tanai-prathapam/-lab7_445L_personal/Lab07BReport.docx

Name: __Jonathan Simon ; Egan Wang ; Aleena Khatum ; Tanai Prathapam____

EID: __jes7539 ; ew23776 ; aak3265 ; tsp824 _____

Semester: Fall 2026

Course: ECE445L

Deliverable 1: I have pushed my updated Requirements document to GitHub (Yes/No): Yes

Deliverable 2: I have pushed my final KiCad project, schematic, and PCB files to GitHub (Yes/No): Yes

Deliverable 3: I have pushed my final MSPM0_Pins_Assignments.xlsx to GitHub (Yes/No): Yes

Deliverable 4: Photographs of the top and bottom (mirrored) of the PCB showing all components are the correct size and the PCB fits in the box (Figure 7A.2 and Figure 7B.7). n/a

Deliverable 5: I have pushed my low-level header, code, unit test files, and integration test file to GitHub (Yes/No): Yes

Deliverable 6: Include results of integration testing.

E) Analysis and Discussion Questions:

1. List the debugging techniques you used to do integration testing? How intrusive were they?
  a. We tested things individually first because unit testing let us ensure that the fundamental pieces operate as intended. In particular, we built a single LED group and tested that on a breadboard, the keypad was also build and testing on a breadboard, the mister was connected to a single 3v3 line and the microcontroller and interacted with using a GPIO pin, the barcode scanner was tested with the microcontroller directly using two 3v3 lines. The LCDs have been tested in previous labs. We used memory dumps, multimeters for active voltage testing, and message in a bottle testing. The most intrusive form of debugging that we used is print statements. Aside from that, debugging was minimally intrusive.
2. What are one or two high risk aspects of your design, and what mitigation steps have you taken to reduce risks?
  a. A lot of the code was reused from previous labs, so a few risks of combining previous code is overlapping interrupts and CPU utilization.
  b. When designing the PCB, we did so without knowing the actual pitch of the JST connectors. Similarly, for printing the coils, we designed them without knowing the actual measurements of the motor shaft. So, we needed to figure out the measurements using alternate methods. Also, a big part of our design was dependent on the coil printing well and being stiff enough to dispense vending machine items.
3. Explain which team skill (https://users.ece.utexas.edu/~valvano/EE445L/ebook/Chapter3_HumanInterfaces.htm) has been most difficult so far for your group.
  a. I think the team skill that has been most difficult for our group is time management . It is really difficult to coordinate all of our schedules when everyone is so busy and involved in so many different things. The way that we have worked around that is by trying to make it routine to stay in the lab on days that we have checkout.

Lab 7B report ECE445L
