tanai-prathapam/-lab7_445L_personal/RequirementsDocument.docx

## Project Requirements Document:

1) Overview

a) Objectives: Build a miniature carnival-themed vending machine that dispenses candy through keypad selection and combines student ID scanning, LCD displays, lighting, music, mist, and a launcher into an interactive experience.

b) Interactions with Existing Systems: The main controller will interface with the barcode scanner, SD card, LCDs, and peripheral driver circuits. No connection to a campus identification database is planned.

c) Terminology:

- PCB: Printed circuit board connecting the electronic components.
- UI: User interface for displaying instructions and selections.
- Vending coil: Motor-driven spiral that releases a selected product.
- Ejection orifice: Output opening through which candy is launched.

2) Functional Description

a) Functionality: The system will read student ID barcodes and accept product selections through a keypad. One LCD will display SD card content, and the other will display the active UI. The selected vending coil will release candy into the output area. LEDs will illuminate when candy arrives, and the launcher will eject it toward the user. Speakers will play background music, and misters will produce mist around the output opening.

i) Data flow graph:

flowchart TD

A["Keypad selection"] --> C["Controller"]

B["Student ID barcode"] --> C

D["SD card content"] --> C

C --> E["LCD displays"]

C --> F["Motor drivers and vending coils"]

F --> G["Candy in output area"]

G --> H["Arrival indication"]

H --> C

C --> I["Launcher actuation"]

C --> J["LEDs, speakers, and misters"]

The method for detecting candy arrival will be finalized during implementation.

b) Performance: The following are proposed acceptance targets.

Measure | Target | Verification
Keypad response | UI updates within 250 ms | Time input-to-display response
Barcode reading | At least 9 successful reads in 10 attempts | Scan supported student IDs
Dispensing accuracy | Correct product released in at least 9 of 10 trials | Test each product slot
Dispensing time | Candy reaches the output area within 5 seconds of selection | Time repeated trials
Launch consistency | Candy reaches a defined collection zone in at least 9 of 10 trials | Test at a fixed launcher setting
Integrated operation | Complete 10 consecutive cycles without reset or jam | Run the full system

c) Usability: The keypad will provide labeled product choices. The active UI will show instructions, the selected product, and dispensing status. The second LCD will display SD card content. Lighting will identify the output opening, and launching will occur only when the output path is clear.

i) Proposed call graph:

flowchart TD

A["main()"] --> B["initializeSystem()"]

A --> C["processInputs()"]

A --> D["updateDisplays()"]

A --> E["runVendingCycle()"]

C --> F["readKeypad()"]

C --> G["readBarcode()"]

D --> H["readSDContent()"]

E --> I["dispenseProduct()"]

E --> J["controlEffects()"]

E --> K["launchProduct()"]

3) Deliverables

a) Roles and Responsibilities:

Team member | Responsibilities
Egan | PCB schematic and routing
Jonathan | Hardware and software for the barcode scanner, misters, and keypad
Aleena | Hardware and software for LEDs, SD card, motors, solenoid, speakers, and vending coils
Tanai | Enclosure and launching mechanism, including the winch motor

All members will contribute to integration, testing, and documentation. Aleena and Tanai will coordinate the launcher’s electrical and mechanical interfaces.

b) Reports: Reports for Labs 7A, 7B, and 10 will be written and submitted.

c) Outcomes: The primary deliverable is a working miniature carnival-themed vending machine with an assembled PCB, enclosure, firmware, and integrated peripherals. Supporting deliverables include schematics, PCB layout files, source code, and test results. The project is complete when all listed features operate together and meet the agreed acceptance targets.
