tanai-prathapam/-lab7_445L_personal/Lab07AReport.docx

Name: __Jonathan Simon ; Egan Wang ; Aleena Khatum ; Tanai Prathapam____

EID: __jes7539 ; ew23776 ; aak3265 ; tsp824 _____

Semester: Fall 2026

Course: ECE445L

All team members have reviewed and approved team skills contract (https://users.ece.utexas.edu/~valvano/EE445L/ebook/Chapter3_HumanInterfaces.htm) (Yes/No): Yes

https://docs.google.com/document/d/1b0H_l2s_C3Buwb_I0p0ZEJCIzjKjUqObAgL3oR6PWzI/edit?usp=sharing

Deliverable 1: I have pushed my updated Requirements document to GitHub (Yes/No): Yes

Deliverable 2: I have pushed my KiCad preliminary schematic to GitHub (Yes/No): Yes

Deliverable 3: I have pushed my updated MSPM0_Pins_Assignments.xlsx to GitHub (Yes/No): Yes

Deliverable 4: I have pushed my updated BOM to GitHub (Yes/No): Yes

Deliverable 5: List the needed supply voltages and estimated current for each voltage (show how these were determined).

Rail | Subcomponent | Active current (mA) | Idle current (mA) | Design-check current (mA) | Basis or calculation
3.3 V | uC1 | 8.1 | 8.1 | 12 | Active: 1 MCU x 8.1 mA = 8.1 mA, D typical reference. Idle: same RUN-current allowance = 8.1 mA, A; sleep is not established. Design: 1 x 12 mA = 12 mA, A.
3.3 V | uC2 | 8.1 | 8.1 | 12 | Active: 1 MCU x 8.1 mA = 8.1 mA, D typical reference. Idle: same RUN-current allowance = 8.1 mA, A. Design: 1 x 12 mA = 12 mA, A.
3.3 V | UDecoder1 | 0.100 | 0.010 | 1.000 | A allowances: active = 0.100 mA; idle = 0.010 mA; design = 1.000 mA..
3.3 V | RPU1 / CH_PD input leakage | 0.001 | 0.001 | 0.010 | A leakage: active and idle = 1 uA / 1000 = 0.001 mA. Design = 10 uA / 1000 = 0.010 mA. The pull-up does not continuously draw 3.3 V / 10 kOhm when its input is high.
3.3 V | RPU2 | 0.165 | 0 | 0.330 | Low-state current = (3.3 V - 0 V) / 10 kOhm = 0.330 mA. Active: 0.330 mA x 0.50 low-state fraction = 0.165 mA, A duty. Idle: (3.3 V - 3.3 V) / 10 kOhm = 0 mA. Design: 0.330 mA x 1 = 0.330 mA.
3.3 V | ESP8266 module | 80 | 50 | 300 | Active: 1 x 80 mA = 80 mA, C average applied to the module. Idle: 1 x 50 mA = 50 mA, A. Design burst: 1 x 300 mA = 300 mA, A.
3.3 V | TFT1, including backlight | 50 | 50 | 60 | Active: approximately 50 mA with full backlight, D manufacturer reference. Idle: backlight remains on, so 1 x 50 mA = 50 mA, A application. Design: 1 x 60 mA = 60 mA, A.
3.3 V | TFT2, including backlight | 50 | 50 | 80 | A similar-display allowances: active = 1 x 50 mA = 50 mA; idle with backlight on = 50 mA; design = 1 x 80 mA = 80 mA.
3.3 V | One SD card | 10.9 | 1 | 100 | All A. Active average = (0.10 x 100 mA) + (0.90 x 1 mA) = 10.9 mA. Idle = 1 mA. Design access current = 100 mA. Subtract this row if no card is installed.
3.3 V | LS1 through Q16 | 20.625 | 0 | 412.5 | Conditional A model: on-current = (3.3 V - 0 V) / 8 Ohm = 0.4125 A = 412.5 mA. Active average = 412.5 mA x 0.50 tone duty x 0.10 audio occupancy = 20.625 mA. Idle = 0. Design continuous-on case = 412.5 mA.
3.3 V | LS2 through Q17 | 20.625 | 0 | 412.5 | Conditional A model: on-current = (3.3 V - 0 V) / 8 Ohm = 412.5 mA. Active average = 412.5 mA x 0.50 x 0.10 = 20.625 mA. Idle = 0. Design continuous-on case = 412.5 mA.
3.3 V, provisional | Atomizer1 | 150 | 1 | 300 | A module allowances: active = 1 x 150 mA = 150 mA; disabled idle = 1 mA; design = 300 mA.
3.3 V, provisional | Atomizer2 | 150 | 1 | 300 | A module allowances: active = 1 x 150 mA = 150 mA; disabled idle = 1 mA; design = 300 mA.
3.3 V | ID reader | 190 | 20 | 250 | Active allowance = 1 x 190 mA = 190 mA, A proxy based on a representative reader. Idle = 20 mA, A. Design = 250 mA, A. Your exact reader has not been identified.
3.3 V | LED branch 1 | 23.334 | 0 | 30.801 | A: R = 53.57 Ohm from the schematic note; nominal Vf = 2.0 V; Vds = 0.05 V. Active = (3.3 V - 2.0 V - 0.05 V) / 53.57 Ohm = 23.334 mA. Idle = 0. Design with Vf = 1.6 V: (3.3 - 1.6 - 0.05) V / 53.57 Ohm = 30.801 mA.
3.3 V | LED branch 2 | 0 | 0 | 30.801 | A operating state: active and idle = 0 because this LED is off. Design: (3.3 V - 1.6 V - 0.05 V) / 53.57 Ohm = 30.801 mA.
3.3 V | LED branch 3 | 0 | 0 | 30.801 | A operating state: active and idle = 0 because this LED is off. Design: (3.3 V - 1.6 V - 0.05 V) / 53.57 Ohm = 30.801 mA.
3.3 V | Keypad pull currents | 0.0825 | 0 | 1.320 | A equivalent pulls and scan duty. Active = (3.3 V / 10 kOhm) x 0.25 = 0.0825 mA. Idle assumes no conducting pull path = 0. Design = 4 conducting paths x (3.3 V / 10 kOhm) = 1.320 mA.
3.3 V | External MOSFET gate charging | 0.0144 | 0 | 0.048 | Igate = number of switching gates x Qg x frequency. Active = 3 x 2.4 nC x 2 kHz = 14.4 uA = 0.0144 mA. Idle assumes no switching = 0. Design = 4 x 6 nC x 2 kHz = 48 uA = 0.048 mA. D gate-charge references; A frequency, gate count and application to 3.3 V drive.
3.3 V | U1 VREF/control inputs | 0.043 | 0.010 | 0.120 | Active = 10 uA assumed VREF leakage + 33 uA datasheet typical high-input current = 43 uA = 0.043 mA. Idle = 10 uA / 1000 = 0.010 mA, A. Design = 20 uA assumed VREF leakage + 100 uA datasheet maximum high-input current = 0.120 mA.
3.3 V | Other leakage | 0.100 | 0.100 | 1.000 | A aggregate allowance for capacitor, protection and other small leakage: active = 0.100 mA; idle = 0.100 mA; design = 1.000 mA.
5 V | M1–M12, one selected N20 motor | 98 | 0 | 980 | S: 35 mA at 3 V and 56 mA at 6 V, loading unspecified. A interpolation: 35 mA + [(5 V - 3 V) / (6 V - 3 V)] x (56 mA - 35 mA) = 49 mA. Active allowance = 2 x 49 mA = 98 mA. Idle = 0. Design allowance = 20 x 49 mA = 980 mA.
12 V | Mwinch1 | 1000 | 0 | 3000 | A allowances: running = 1 x 1.0 A = 1000 mA; idle = 0; startup/stall design allowance = 1 x 3.0 A = 3000 mA.
12 V | DRV8231A supply overhead | 3 | 0.001 | 4 | D references at VM = 24 V: active typical = 3 mA; sleep maximum = 1 uA / 1000 = 0.001 mA; active maximum = 4 mA. Using these at 12 V is A.
12 V | Mfeeder1 solenoid | 1200 | 0 | 1200 | S energized current: 1.2 A x 1000 = 1200 mA. Equivalent resistance = 12 V / 1.2 A = 10 Ohm. Idle = 0. Design uses the supplied 1200 mA on-current, not a verified maximum.
12 V | Other leakage | 0.100 | 0.100 | 1.000 | A aggregate allowance: active = 0.100 mA; idle = 0.100 mA; design = 1.000 mA.

Deliverable 6: I have pushed my low-level header, code, and unit test files to GitHub (Yes/No): Yes

Deliverable 7: Include results of unit testing.

All unit testing was done within the same project where the main file had different DEBUG_MODEs to select the specific component we want to test. Our unit testing showed a successful toggle of the water atomizer. The motor and barcode reader unit testing is currently in progress. The hardware is in our hands, and we are verifying it is functional first by supplying power.

Deliverable 8 (5pt EC): Show dated proof of TIW Training (due at the time of Lab7A report)

~~Deliverable~~ ~~9~~ ~~(10pt EC):~~ ~~single chip (points given in Lab 10 if the single chip works)~~

Analysis and Discussion Questions:

1. List the debugging techniques you used to do unit testing? How intrusive were they?

We completely isolated the test of each component by assigning different DEBUG_MODES. In each test, only the specific component’s hardware is initialized and then tested by calling its respective functions. To test whether the microcontroller GPIO PA1 pin is properly outputting the correct voltage after every 5 seconds, we used a DVM to measure the output voltage. The mister’s board came with an LED that showed the state it is in and aided in our debugging to understand what the board is attempting to do. The DVM is not intrusive as it is just reading the voltage out of the GPIO pin.

2. What are the differences between unit testing, integration testing, and functional testing?

Unit testing tests the individual modules completely isolated from the other modules. Integration testing puts all the modules together and to validate that they can coordinate their tasks at the appropriate time. Functional testing tests if all their outputs when working together are all valid and expected outputs.

Lab 7A report ECE445L
