tanai-prathapam/-lab7_445L_personal/sw/src/LM4041design.xlsx

Goal: design a shunt reference circuit
Jonathan Valvano, ECE445L
Desired Vz | 1.65 | volts | 1) pick a desired reference voltage Vz (volts)
Vref | 1.233 | volts | LM4041 parameter
R1 | 47 | kohm | 2) choose a standard resistance value (kohm)
best R2 | 15.89537713 | kohm
Pick R2 | 16 | kohm | 3) pick a standard value for R2 close to best R2
Actual Vref | 1.652744681 | volts | Vz=Vref(1+R2/R1)
Vs | 3.3 | volts | V supply
Rin | 10000 | kohm | 4) estimate input impedence on Vz (e.g., to DAC)
Iz | 0.08 | mA | LM4041 parameter
Iref | 0.02623404255 | mA | Vz/(R1+R2), Ohms Law, current through R1,R2
IL | 0.0001652744681 | mA | Vz/Rin, Ohms Law, current through Rin
I total | 0.106399317 | mA | Iz+Iref+IL
max Rs | 15.4818223 | kohm | (Vs-Vz)/Itotal
 |  |  | 5) choose Rs less than max Rs
