tanai-prathapam/-lab7_445L_personal/hw/ECE445L_Lab7/Water Atomizer Reverse Engineering.pptx

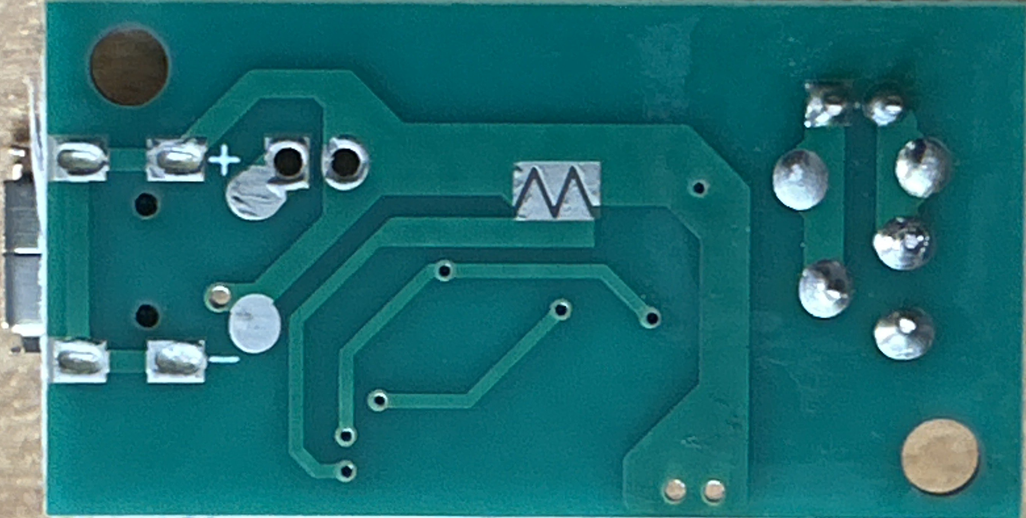
[picture p1: figure]
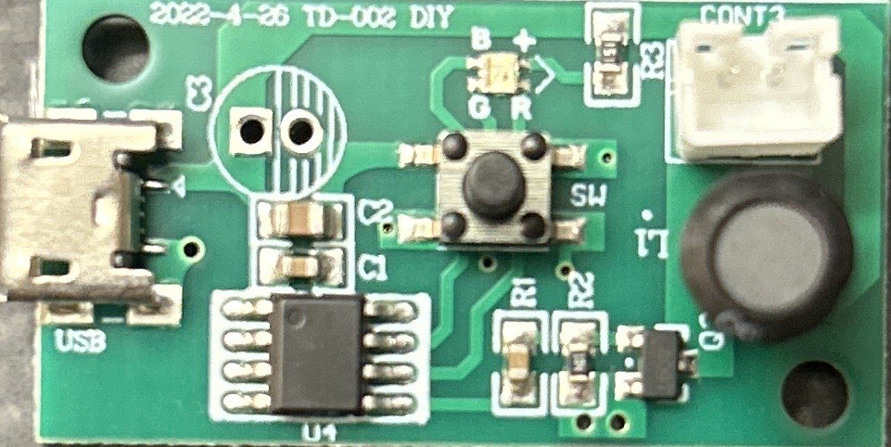
[picture p2: figure]
