tanai-prathapam/-lab7_445L_personal/Lab7BOM_orders.xlsx

Bill of Materials |  |  | 2026-10-30 | "not free" means you have to buy it |  | "free sample" means you have to order it
ECE445L Fall 2026 |  |  | EE445L pays for the PCB | "Cabinet means in one of the six black cabinets in professsor's office (bring a print out of your SCH")
 |  |  |  | "Professor" means ask your professor quantity and style will vary (bring a print out of your SCH circuit)
Qty Note | REF DES Note (http://projects.ece.utexas.edu/valvano/wiki/doku.php?id=pcbartist:schematics) |  |  | "Box means in box in your professor's office (bring a print out of your SCH circuit)
Quantity | REF DES | Type | Description | Manufacturer | Mfg. P/N | Distributor | P/N | Unit cost | Cost | Where to get it? | Inventory | Order link
2 | LS1, LS2 | ASM | Speakers |  |  |  |  | $0.00 | $0.00 | Checkout
0 |  | ASM | 9V battery snap, T-type |  |  |  |  | $0.50 | $0.00 | Box
0 |  | ASM | Black case, 7.5" by 4.3" by 2.2" | Hammond | 1591ESBK | Mouser | 546-1591ES-BK | $5.18 | $0.00 | Box | http://www.hammondmfg.com/pdf/1591E.pdf
0 |  | ASM | Electret microphone | Panasonic |  |  |  | $0.50 | $0.00 | Cabinet
0 |  | CAP | Ceramic, X7R, 20%, 1 uF |  |  | Jameco | 81509 | $0.35 | $0.00 | Cabinet
0 |  | CAP | Ceramic, Z5U, -20/+80%, 0.47 uF | Kemet | C320C474M5U5TA | Digikey | 399-4309-ND | $0.40 | $0.00 | Cabinet
0 |  | CAP | Ceramic, Z5U, -20/+80%, 0.1 uF |  |  | Digikey | 399-4151-ND | $0.04 | $0.00 | Cabinet
0 |  | CAP | Ceramic, Z5U, -20/+80%, 0.033 uF |  |  | Digikey | 399-4298-ND | $0.40 | $0.00 | Cabinet
0 |  | CAP | Ceramic, Z5U, -20/+80%, 0.027uF |  |  |  |  | $0.40 | $0.00 | Cabinet
0 |  | CAP | Ceramic, Z5U, -20/+80%, 0.01 uF |  |  | Digikey | 399-4148-ND | $0.40 | $0.00 | Cabinet
0 |  | CAP | Ceramic, Z5U, -20/+80%, 4.7 nF |  |  | Digikey | 399-4188-ND | $0.40 | $0.00 | Cabinet
0 |  | CAP | Ceramic, Z5U, -20/+80%, 2.2 nF |  |  |  |  | $0.40 | $0.00 | Cabinet
0 |  | CAP | Ceramic, Z5U, -20/+80%, 1 nF |  |  |  |  | $0.40 | $0.00 | Cabinet
0 |  | CAP | Ceramic Z5U, -20/+80%, 470 pF |  |  |  |  | $0.03 | $0.00 | Cabinet
0 |  | CAP | Ceramic Z5U, -20/+80%, 330 pF |  |  |  |  | $0.03 | $0.00 | Cabinet
0 |  | CAP | Ceramic Z5U, -20/+80%, 220 pF |  |  |  |  | $0.03 | $0.00 | Cabinet
0 |  | CAP | Ceramic Z5U, -20/+80%, 100 pF |  |  |  |  | $0.03 | $0.00 | Cabinet
0 |  | CAP | Ceramic Z5U, -20/+80%, 22 pF |  |  | Jameco | 15405 | $0.03 | $0.00 | Cabinet
0 |  | CAP | Ceramic C0G, 10%, 10 pF | Murata 50V 5% | RDE5C1H100J0P1H03B | Digikey | 490-8629-ND | $0.31 | $0.00 | Cabinet
0 |  | CAP-Tant | Tantalum, 16V, 20% 2.2 uF | AVX Corporation | TAP225M016CCS | Digikey | 478-8819-ND | $0.29 | $0.00 | Cabinet
0 |  | CAP-Tant | Tantalum, 16V, 10% 4.7 uF |  |  | Digikey | 478-1904-ND | $0.22 | $0.00 | Cabinet
0 |  | CAP-Tant | Tantalum, 20V, 10%, 1 uF |  |  | Digikey | 478-1833-ND | $0.32 | $0.00 | Cabinet
0 |  | CAP-Tant | Tantalum, 10UF 20V 10% |  |  | Digikey | 478-1840-ND | $0.56 | $0.00 | Cabinet
0 |  | CAP-Tant | Tantalum, 35V, 10%, 0.47 uF |  |  | Jameco | 33531 | $0.19 | $0.00 | Cabinet
0 |  | CAP-Elec | Electrolytic, 16V, 100 uF, cap 20%, ESR=20mV |  |  | Mouser | 661-APSF160E101MF05S | $0.38 | $0.00 | Cabinet
0 |  | CON | 2 to 40 pin 0.1 in header (price per pin) |  |  | AllElectronics | SHS-40 | $0.02 | $0.00 | Cabinet
0 |  | CON | 2-pin header |  |  | AllElectronics | SBH-2 | $0.10 | $0.00 | Cabinet
0 |  | CON | 2-pin jumper |  |  | AllElectronics | SBC-2 | $0.27 | $0.00 | Cabinet
0 |  | CON | 2-pin jumper |  |  | AllElectronics | SJ-1 | $0.10 | $0.00 | Cabinet
0 |  | CON | Test point, black | Keystone Electronics | 5001 | Digikey | 36-5001K-ND | $0.23 | $0.00 | Cabinet
0 |  | CON | Test point, orange | Keystone Electronics | 5003 | Digikey | 36-5003K-ND | $0.23 | $0.00 | Cabinet
0 |  | CON | Test point, yellow | Keystone Electronics | 5004 | Digikey | 36-5004K-ND | $0.23 | $0.00 | Cabinet
0 |  | CON | Test point, white | Keystone Electronics | 5002 | Digikey | 36-5002K-ND | $0.23 | $0.00 | Cabinet
0 |  | CON | Test point, blue | Keystone Electronics | 5117 | Digikey | 36-5117-ND | $0.23 | $0.00 | Cabinet
0 |  | CON | Test point, green | Keystone Electronics | 5116 | Digikey | 36-5116-ND | $0.23 | $0.00 | Cabinet
0 |  | CON | Test point, red | Keystone Electronics | 5000 | Digikey | 36-5000K-ND | $0.23 | $0.00 | Cabinet
0 |  | CON | 10-pin LCD connector | SamTec | BCS-110-L-S-TE | SamTec |  |  | $0.00 | Cabinet
0 |  | CON | 14-pin LCD connector | SamTec | BCS-114-L-S-TE | SamTec |  |  | $0.00 | Cabinet
0 |  | CON | 16-pin LCD connector | SamTec | BCS-116-L-S-TE | SamTec |  |  | $0.00 | Cabinet
0 |  | CON | 20-pin LCD connector | SamTec | BCS-120-L-S-TE | SamTec |  |  | $0.00 | Cabinet
0 |  | CON | Socket for micro SD card | Molex | 473340001 | Digikey | WM3288CT-ND | $4.02 | $0.00 | professor | do not use, rather included on ST7735
0 |  | CON | USB Mini-B socket, board mount, surface mount | Molex | 56579-0576 | Mouser | 538-56579-0576 | $2.46 | $0.00 | Cabinet
 |  | CON | Micro USB Type B, surface mount | Hirose Connector | ZX62D-B-5PA8(30) | Mouser | 798-ZX62D-B-5PA830 | $0.47 | $0.00 | Cabinet
0 |  | CON | USB Mini-B socket, board mount, through hole | Molex | 54819-0519 | Digikey | WM17115-ND | $0.65 | $0.00 | Cabinet
0 |  | CON | BoosterPack connector | FCI | 68021-208HLF | Digikey | 609-3243-ND | $0.26 | $0.00 | Cabinet
0 |  | CON | Logic Analyzer connector | FCI | 68021-208HLF | Digikey | 609-3344-ND | $0.27 | $0.00 | Cabinet
0 |  | CON | JTAG 1 by 5 male header |  |  |  |  | $0.29 | $0.00 | Cabinet
0 |  | CON | 10 pin 2mm socket for Xbee (need two) | SamTec | SQT-110-01-F-S | SamTec |  | $1.00 | $0.00 | Cabinet
0 |  | CON | DB9 serial connector, female, board mount |  |  | Jameco | 15771 | $0.65 | $0.00 | Cabinet
0 |  | CPU | TM4C123GH6PM 64-pin LQFP | TI | TM4C123GH6PMI | Mouser | 595-TM4C123GH6PMI | $11.55 | $0.00 | not required, we expect most students will create a system with the LaunchPad
0 |  | CRYS | NX5032GA-16.000000 | NDK | NX5032GA-16.000000 | Digikey | 644-1037-1-ND | $0.51 | $0.00 | Cabinet | not required, we expect most students will create a system with the LaunchPad
0 |  | DIODE | 1N914 diode | Fairchild | 1N914 | Digikey | 1N914B-ND | $0.05 | $0.00 | Cabinet
0 |  | IC | ACCELER DUAL-AX 2.0G 8PLCC | Analog Devices | ADXL202JQC | Quest Components | ADXL202JQC | $7.50 | $0.00 | professor
0 |  | IC | LM2937 3.3 V regulator TO220, 500mA | TI | LM2937ET-3.3/NOPB | Digikey | LM2937ET-3.3-ND | $1.17 | $0.00 | Cabinet
0 |  | IC | LP2950 3.3V regulator, 100 mA TO-92 | TI | LP2950-33LPRE3 | Digikey | 296-31455-1-ND | $0.19 | $0.00 | Cabinet
0 |  | IC | 78M05 500mA 5V TO-220 regulator | National | LM78M05 | Jameco | 192233 | $0.19 | $0.00 | Cabinet
0 |  | IC | OPA4350 quad op amp | TI | OPA4350 | TI |  |  | $0.00 | free sample
0 |  | IC | TLV5616 12-bit DAC | TI | TLV5616 | TI | TLV5616CP |  | $0.00 | Cabinet or free sample
0 |  | IC | TLV5618 dual 12-bit DAC | TI | TLV5618 | TI | TLV5618ACP |  | $0.00 | free sample
0 |  | IC | MAX539 12-bit DAC | Maxim-IC | MAX539 | Maxim | MAX539ACPA |  | $0.00 | free sample
0 |  | IC | MAX1247 12-bit ADC | Maxim-IC | MAX1247 | Maxim | MAX1247ACPE+ |  | $0.00 | free sample
0 |  | IC | INA122P instrumentation amp | TI | INA122P | TI | INA122P |  | $0.00 | Cabinet or free sample
0 |  | IC | OPA2350 dual op amp | TI | OPA2350PA | TI | OPA2350PA |  | $0.00 | Cabinet or free sample |  |  |  | 1 KD
0 |  | IC | TLC2274 quad op amp | TI | TLC2274ACN | TI | TLC2274ACN | $1.17 | $0.00 | free sample |  |  |  | 2 HD
0 |  | IC | TPA731 audio amp (pin 1 low) 700mW | TI | TPA731D | TI | TPA731D | $1.84 | $0.00 | Cabinet or free sample |  |  |  | 3 AD
0 |  | IC | TPA751 audio amp (pin 1 high) 700mW | TI | TPA751D | TI | TPA751D | $1.84 | $0.00 | free sample |  |  |  | 4 JD
0 |  | IC | LM4041CILPR shunt diode reference | TI | LM4041CILPR | TI | LM4041CILPR | $0.90 | $0.00 | Cabinet or free sample |  |  |  | 5 CD
0 |  | IC | AD8032 dual op amp | Analog Devices | AD8032ANZ | Analog Devices | AD8032ANZ | $4.47 | $0.00 | free sample |  |  |  | 6 BD
0 |  | IC | L293 Motor H bridge | TI | L293NE | Digikey | 296-9519-5-ND | $3.50 | $0.00 | not free |  |  |  | 7 MD
0 |  | IC | DRV8848 | TI | DRV8848PWP | TI
0 |  | IC | 74HC595 |  |  | Jameco | 46105 | $0.40 | $0.00 | Cabinet |  |  |  | 8 ED
0 |  | IC | 74HC165 |  |  | Jameco | 45495 | $0.30 | $0.00 | Cabinet |  |  |  | 9 FD
0 |  | IC | 74HCT125N | TI | SN74HCT125N | Mouser | 595-SN74HCT125N | $0.53 | $0.00 | Cabinet |  |  |  | 9 FD
0 |  | IC | RS232 driver | STMicroelectronics | ST232CN | Jameco | 2001171 | $0.58 | $0.00 | not free |  |  |  | 0 ND
0 |  | JACK | DC Power MALE 2.1mm |  |  | Jameco | 101179 | $0.55 | $0.00 | Cabinet |  |  |  | * LD
0 |  | JACK | Stereo Jack, or audio jack |  |  | AllElectronics | MJW-12 | $0.09 | $0.00 | Cabinet |  |  | 87YY3212A
0 |  | KEY | 3 by 4 common bus (D), keypad | Grayhill | 87YY3212A-506 | BGMicro | SWT1109 | $2.99 | $0.00 | Box | http://docs.bgmicro.com/pdf/swt1109.pdf
 |  | LCD | 84 by 48 LCD | Nokia | 5110 | Sparkfun | 10168 | $9.95 | $0.00 | not free
1 | TFT1 | LCD | 18-bit color 128*160 1.8" TFT LCD display | Adafruit | 358 | Mouser |  | $19.95 | $0.00 | Cabinet | Schematic TFT1; cost from schematic, not a current quote
0 |  | LED | Green 2mA 5mm diffused | Avago Technologies | HLMP-4740 | Digikey | 516-1327-ND | $0.29 | $0.00 | Cabinet
0 |  | LED | Red 1.6V 1mA 5mm diffused | Avago Technologies | HLMP-D150 | Digikey | 516-1323-ND | $0.29 | $0.00 | Cabinet
0 |  | LED | Yellow 2mA 5mm diffused | Avago Technologies | HLMP-4719 | Digikey | 516-1326-ND | $0.29 | $0.00 | Cabinet
0 |  | LED | Orange 10mA 5mm diffused | Avago Technologies | HLMP-D401 | Digikey | 516-1330-ND | $0.29 | $0.00 | Cabinet
0 |  | LED | Blue 10mA 5mm diffused |  |  |  |  | $0.99 | $0.00 | Cabinet | warning, the blue LEDs are very bright
0 |  | PCB | PCB plus shipping | JLCPCB |  | JLCPCB |  | $20.00 | $0.00 | http://www.4pcb.com/
0 |  | POT | 20K LINEAR SLIDE POT |  |  |  |  | $0.33 | $0.00 | professor
0 |  | POT | 10 K one-turn potentiometer |  |  |  |  | $0.15 | $0.00 | Cabinet
0 |  | POT | 20 K one-turn potentiometer |  |  |  |  | $0.15 | $0.00 | Cabinet
0 |  | RES | Carbon 1/6W, 5%, 100 | Yageo | CFR-12JB-100R | Digikey | 100EBK-ND | $0.02 | $0.00 | Cabinet
0 |  | RES | Carbon 1/6W, 5%, 220 | Yageo | CFR-12JB-220R | Digikey | 220EBK-ND | $0.02 | $0.00 | Cabinet
0 |  | RES | Carbon 1/6W, 5%, 270 | Yageo | CFR-12JB-270R | Digikey | 270EBK-ND | $0.02 | $0.00 | Cabinet
0 |  | RES | Carbon 1/6W, 5%, 330 | Yageo | CFR-12JB-330R | Digikey | 330EBK-ND | $0.02 | $0.00 | Cabinet
0 |  | RES | Carbon 1/6W, 5%, 470 | Yageo | CFR-12JB-470R | Digikey | 470EBK-ND | $0.02 | $0.00 | Cabinet
0 |  | RES | Carbon 1/6W, 5%, 510 | Yageo | CFR-12JB-510R | Digikey | 510EBK-ND | $0.02 | $0.00 | Cabinet
0 |  | RES | Carbon 1/6W, 5%, 680 | Yageo | CFR-12JB-680R | Digikey | 680EBK-ND | $0.02 | $0.00 | Cabinet
0 |  | RES | Carbon 1/6W, 5%, 820 | Yageo | CFR-12JB-820R | Digikey | 820EBK-ND | $0.02 | $0.00 | Cabinet
0 |  | RES | Carbon 1/6W, 5%, 1K | Yageo | CFR-12JB-1K0 | Digikey | 1.0KEBK-ND | $0.02 | $0.00 | Cabinet
0 |  | RES | Carbon 1/6W, 5%, 1.2K | Yageo | CFR-12JB-1K2 | Digikey | 1.2KEBK-ND | $0.02 | $0.00 | Cabinet
0 |  | RES | Carbon 1/6W, 5%, 1.5K | Yageo | CFR-12JB-1K5 | Digikey | 1.5KEBK-ND | $0.02 | $0.00 | Cabinet
0 |  | RES | Carbon 1/6W, 5%, 1.8K | Yageo | CFR-12JB-1K8 | Digikey | 1.8KEBK-ND | $0.02 | $0.00 | Cabinet
0 |  | RES | Carbon 1/6W, 5%, 2.0K | Yageo | CFR-12JB-2K0 | Digikey | 2.0KEBK-ND | $0.02 | $0.00 | Cabinet
0 |  | RES | Carbon 1/6W, 5%, 2.2K | Yageo | CFR-12JB-2K2 | Digikey | 2.2KEBK-ND | $0.02 | $0.00 | Cabinet
0 |  | RES | Carbon 1/6W, 5%, 2.7K | Yageo | CFR-12JB-2K7 | Digikey | 2.7KEBK-ND | $0.02 | $0.00 | Cabinet
0 |  | RES | Carbon 1/6W, 5%, 3.3K | Yageo | CFR-12JB-3K3 | Digikey | 3.3KEBK-ND | $0.02 | $0.00 | Cabinet
0 |  | RES | Carbon 1/6W, 5%, 3.9K | Yageo | CFR-12JB-3K9 | Digikey | 3.9KEBK-ND | $0.02 | $0.00 | Cabinet
0 |  | RES | Carbon 1/6W, 5%, 4.7K | Yageo | CFR-12JB-4K7 | Digikey | 4.7KEBK-ND | $0.02 | $0.00 | Cabinet
0 |  | RES | Carbon 1/6W, 5%, 5.1K | Yageo | CFR-12JB-5K1 | Digikey | 5.1KEBK-ND | $0.02 | $0.00 | Cabinet
0 |  | RES | Carbon 1/6W, 5%, 5.6K | Yageo | CFR-12JB-5K6 | Digikey | 5.6KEBK-ND | $0.02 | $0.00 | Cabinet
0 |  | RES | Carbon 1/6W, 5%, 6.8K | Yageo | CFR-12JB-6K8 | Digikey | 6.8KEBK-ND | $0.02 | $0.00 | Cabinet
0 |  | RES | Carbon 1/6W, 5%, 8.2K | Yageo | CFR-12JB-8K2 | Digikey | 8.2KEBK-ND | $0.02 | $0.00 | Cabinet
0 |  | RES | Carbon 1/6W, 5%, 10K | Yageo | CFR-12JB-10K | Digikey | 10KEBK-ND | $0.02 | $0.00 | Cabinet
0 |  | RES | Carbon 1/6W, 5%, 12K | Yageo | CFR-12JB-12K | Digikey | 12KEBK-ND | $0.02 | $0.00 | Cabinet
0 |  | RES | Carbon 1/6W, 5%, 15K | Yageo | CFR-12JB-15K | Digikey | 15KEBK-ND | $0.02 | $0.00 | Cabinet | http://www.kemet.com/kemet/web/homepage/kechome.nsf/vapubfiles/F3101_GoldMax.pdf/$file/F3101_GoldMax.pdf
0 |  | RES | Carbon 1/6W, 5%, 18K | Yageo | CFR-12JB-18K | Digikey | 18KEBK-ND | $0.02 | $0.00 | Cabinet
0 |  | RES | Carbon 1/6W, 5%, 20K | Yageo | CFR-12JB-20K | Digikey | 20KEBK-ND | $0.02 | $0.00 | Cabinet
0 |  | RES | Carbon 1/6W, 5%, 22K | Yageo | CFR-12JB-22K | Digikey | 22KEBK-ND | $0.02 | $0.00 | Cabinet
0 |  | RES | Carbon 1/6W, 5%, 27K | Yageo | CFR-12JB-27K | Digikey | 27KEBK-ND | $0.02 | $0.00 | Cabinet
0 |  | RES | Carbon 1/6W, 5%, 36K | Yageo | CFR-12JB-36K | Digikey | 36KEBK-ND | $0.02 | $0.00 | Cabinet
0 |  | RES | Carbon 1/6W, 5%, 33K | Yageo | CFR-12JB-33K | Digikey | 33KEBK-ND | $0.02 | $0.00 | Cabinet
0 |  | RES | Carbon 1/6W, 5%, 39K | Yageo | CFR-12JB-39K | Digikey | 39KEBK-ND | $0.02 | $0.00 | Cabinet
0 |  | RES | Carbon 1/6W, 5%, 47K | Yageo | CFR-12JB-47K | Digikey | 47KEBK-ND | $0.02 | $0.00 | Cabinet
0 |  | RES | Carbon 1/6W, 5%, 51K | Yageo | CFR-12JB-51K | Digikey | 51KEBK-ND | $0.02 | $0.00 | Cabinet
0 |  | RES | Carbon 1/6W, 5%, 56K | Yageo | CFR-12JB-56K | Digikey | 56KEBK-ND | $0.02 | $0.00 | Cabinet
0 |  | RES | Carbon 1/6W, 5%, 68K | Yageo | CFR-12JB-68K | Digikey | 68KEBK-ND | $0.02 | $0.00 | Cabinet
0 |  | RES | Carbon 1/6W, 5%, 82K | Yageo | CFR-12JB-82K | Digikey | 82KEBK-ND | $0.02 | $0.00 | Cabinet
0 |  | RES | Carbon 1/6W, 5%, 100K | Yageo | CFR-12JB-100K | Digikey | 100KEBK-ND | $0.02 | $0.00 | Cabinet
0 |  | RES | Carbon 1/6W, 5%, 120K | Yageo | CFR-12JB-120K | Digikey | 120KEBK-ND | $0.02 | $0.00 | Cabinet
0 |  | RES | Carbon 1/6W, 5%, 150K | Yageo | CFR-12JB-150K | Digikey | 150KEBK-ND | $0.02 | $0.00 | Cabinet
0 |  | RES | Carbon 1/6W, 5%, 180K | Yageo | CFR-12JB-180K | Digikey | 180KEBK-ND | $0.02 | $0.00 | Cabinet
0 |  | RES | Carbon 1/6W, 5%, 200K | Yageo | CFR-12JB-200K | Digikey | 200KEBK-ND | $0.02 | $0.00 | Cabinet
0 |  | RES | Carbon 1/6W, 5%, 220K | Yageo | CFR-12JB-220K | Digikey | 220KEBK-ND | $0.02 | $0.00 | Cabinet
0 |  | RES | Carbon 1/6W, 5%, 240K | Yageo | CFR-12JB-240K | Digikey | 240KEBK-ND | $0.02 | $0.00 | Cabinet
0 |  | RES | Carbon 1/6W, 5%, 270K | Yageo | CFR-12JB-270K | Digikey | 270KEBK-ND | $0.02 | $0.00 | Cabinet
0 |  | RES | Carbon 1/6W, 5%, 330K | Yageo | CFR-12JB-330K | Digikey | 330KEBK-ND | $0.02 | $0.00 | Cabinet
0 |  | RES | Carbon 1/6W, 5%, 390K | Yageo | CFR-12JB-390K | Digikey | 390KEBK-ND | $0.02 | $0.00 | Cabinet
0 |  | RES | Carbon 1/6W, 5%, 470K | Yageo | CFR-12JB-470K | Digikey | 470KEBK-ND | $0.02 | $0.00 | Cabinet
0 |  | RES | Carbon 1/6W, 5%, 510K | Yageo | CFR-12JB-510K | Digikey | 510KEBK-ND | $0.02 | $0.00 | Cabinet
0 |  | RES | Carbon 1/6W, 5%, 560K | Yageo | CFR-12JB-560K | Digikey | 560KEBK-ND | $0.02 | $0.00 | Cabinet
0 |  | RES | Carbon 1/6W, 5%, 680K | Yageo | CFR-12JB-680K | Digikey | 680KEBK-ND | $0.02 | $0.00 | Cabinet
0 |  | RES | Carbon 1/6W, 5%, 820K | Yageo | CFR-12JB-820K | Digikey | 820KEBK-ND | $0.02 | $0.00 | Cabinet
0 |  | RES | Carbon 1/6W, 5%, 1M | Yageo | CFR-12JB-1M0 | Digikey | 1.0MEBK-ND | $0.02 | $0.00 | Cabinet
0 |  | RES | Carbon 1/6W, 5%, 10M | Yageo | CFR-12JB-10M | Digikey | 10MEBK-ND | $0.02 | $0.00 | Cabinet
 |  | SW | Tactile Switch, surface mount | C&K Components | KSC353JLFG | Mouser | 611-KSC353JLFG | $0.86 | $0.00 | Cabinet
0 |  | SW | B3F tactile push button switch | Omron Electronics | B3F-1052 | Digikey | SW405-ND | $0.17 | $0.00 | Cabinet
0 |  | SW | Black Off board momentary push buttom |  |  |  |  | $0.35 | $0.00 | Cabinet
0 |  | SW | Red Off board momentary push buttom |  |  |  |  | $0.35 | $0.00 | Cabinet
0 |  | SW | On/off power switch |  |  | BGMicro | SWT1010 | $0.85 | $0.00 | Cabinet
0 |  | TRAN | PN2222 NPN transistor | Fairchild Semiconductor | PN2222 | Digikey | PN2222BU-ND | $0.13 | $0.00 | Cabinet | be careful to get pins 1 and 3 correct, there are two versions of the chip: 2N2222 and PN2222
0 |  | TRAN | TIP120 Darlington NPN, TO220 | Fairchild | TIP120 | Digikey | TIP120-ND | $0.68 | $0.00 | Cabinet
0 |  | TRAN | TIP125 Darlington PNP, TO220 | Fairchild | TIP125 | Digikey | TIP125TU-ND | $0.67 | $0.00 | Cabinet
0 |  | TRAN | IRF540 MOSFET N-channel, TO220 |  | IRF540 | Digikey | IRF540NPBF-ND | $1.95 | $0.00 | professor
0 |  | TRAN | IRLD120PBF | N-MOSFET | DIP-4 | Mouser | 844-IRLD120PBF | $1.58 | $0.00
1 | U_{Decoder}1 | IC | 4 to 16 Positive Logic Decoder | onsemi | MC14514BDWR2G | Digikey | MC14514BDWR2GOSCT-ND | $1.09 | $1.09 | DigiKey | https://www.digikey.com/en/products/detail/onsemi/MC14514BDWR2G/1478882
18 | Q1, Q10, Q11, Q12, Q15, Q16, Q17, Q18, Q19, Q2, Q20, Q3, Q4, Q5, Q6, Q7, Q8, Q9 | TRAN | N-channel MOSFET, SOT-23 | onsemi | NTR4501NT1G | Valvano | 863-NTR4501NT1G |  | $0.00 |  | https://www.onsemi.com/pub/Collateral/NTR4501N-D.PDF
2 | R_{PU}1, R_{PU}2 | RES | 10 kohm resistor, 0805 | Bourns | CRM0805-FX-1002ELF | Valvano | 652-CRM0805FX1002ELF |  | $0.00 |  | https://www.mouser.com/datasheet/3/40/1/CRM0805_1206_2010.pdf
14 | R_{filter}1, R_{gate}1, R_{gate}10, R_{gate}11, R_{gate}12, R_{gate}15, R_{gate}2, R_{gate}3, R_{gate}4, R_{gate}5, R_{gate}6, R_{gate}7, R_{gate}8, R_{gate}9 | RES | 0.25 ohm resistor, 0603 | YAGEO | RL0603JR-070R25L | Mouser | 603-RL0603JR-070R25L | $0.07 | $1.01 |  | https://www.mouser.com/datasheet/3/508/1/PYU_RL_GROUP_521_ROHS_L.pdf
3 | C_{b,uC}1, C_{b,uC}3, C_{b}16 | CAP | 100 nF capacitor, 0603 | Walsin | 0603B104J160CT | Mouser | 791-0603B104J160CT | $0.10 | $0.30 |  | https://www.mouser.com/datasheet/3/317/1/WTC_MLCC_General_Purpose.pdf
2 | C_{b,uC}2, C_{b,uC}4 | CAP | 10 uF capacitor, 0603 | TDK | C1608X7T1A106M080AC | Mouser | 810-C1608X7T1A106M08 | $0.24 | $0.48 |  | https://product.tdk.com/system/files/dam/doc/product/capacitor/ceramic/mlcc/catalog/mlcc_commercial_general_en.pdf
4 | C_{y}1, C_{y}2, C_{y}3, C_{y}4 | CAP | 10 pF capacitor, 0603 | Walsin | 0603N100F101CT | Mouser | 791-0603N100F101CT | $0.12 | $0.48 |  | https://www.mouser.com/datasheet/3/317/1/WTC_MLCC_General_Purpose.pdf
2 | C_{core}1, C_{core}2 | CAP | 0.47 uF capacitor, 0603 | Walsin | 0603B474K6R3CT | Valvano | 791-0603B474K6R3CT | $0.10 | $0.00 |  | https://www.mouser.com/datasheet/2/210/WTC_MLCC_General_Purpose-1534899.pdf
2 | Y1, Y2 | CRYS | 16 MHz crystal, ABM3 | ABRACON | ABM3-16.000MHZ-B2-T | Valvano | 815-ABM3-16-B2-T | $1.10 | $0.00 |  | https://abracon.com/Resonators/abm3.pdf
2 | uC1, uC2 | CPU | MSPM0G3507-Q1, 32-pin VSSOP | Texas Instruments | M0G3507QDGS32RQ1 | Valvano |  |  | $0.00 |  | https://www.ti.com/lit/ds/symlink/mspm0g3507-q1.pdf?ts=1726224116300
13 | D_{flyback}1, D_{flyback}10, D_{flyback}11, D_{flyback}12, D_{flyback}15, D_{flyback}2, D_{flyback}3, D_{flyback}4, D_{flyback}5, D_{flyback}6, D_{flyback}7, D_{flyback}8, D_{flyback}9 | DIODE | ESD5Z12 diode, SOD-523 | Diotec Semiconductor | ESD5Z12 | Mouser | 637-ESD5Z12 | $0.22 | $2.86 |  | https://diotec.com/request/datasheet/esd5z2v5.pdf
2 | D_{flyback}16, D_{flyback}17 | DIODE | Diode, SOD-882D | Panjit | 241-PE1403M1QR100501 | Mouser | PE1403M1Q_R1_00501 | $0.23 | $0.46 |  | https://www.mouser.com/datasheet/3/3736/1/70DF2AA330BF2D29377481CD66AEFD4146E20D02EF29A331550E35DCFDBB0BAF.pdf
17 | C_{b}1, C_{b}10, C_{b}11, C_{b}12, C_{b}14, C_{b}15, C_{b}17, C_{b}2, C_{b}3, C_{b}4, C_{b}5, C_{b}6, C_{b}7, C_{b}8, C_{b}9, C_{pi}1, C_{pi}2 | CAP | 4.7 uF; 0805 | Walsin | 791-0805X475M250CT | Mouser | 0805X475M250CT | $0.08 | $1.29 |  | https://www.mouser.com/datasheet/2/210/WTC_MLCC_General_Purpose-1534899.pdf
13 | R_{choke}1, R_{choke}10, R_{choke}11, R_{choke}12, R_{choke}15, R_{choke}2, R_{choke}3, R_{choke}4, R_{choke}5, R_{choke}6, R_{choke}7, R_{choke}8, R_{choke}9 | RES | 680 ohm value | Panasonic |  | Valvano |  |  | $0.00 |  | https://industrial.panasonic.com/cdbs/www-data/pdf/RDN0000/AOA0000C313.pdf
4 | R_{vref}1, R_{vref}2, R_{vref}3, R_{vref}4 | RES | 0.5 ohm resistor, 0805 | Vishay/Dale | RCWE0805R500FKEA | Mouser | 71-RCWE0805R500FKEA | $0.33 | $1.32 |  | 20019RCWE.fm (https://www.vishay.com/docs/20019/rcwe.pdf)
3 | R_{I_lim}1, R_{I_lim}2, R_{I_lim}3 | RES | Current-limit resistor, 0603; value blank |  |  | Valvano |  |  | $0.00
1 | C_{filter}1 | CAP-Elec | 1200 uF polarized capacitor | KEMET | A7D0MW128M1EAAS011 | Mouser | 80-A7D0MW128M1EAAS11 | $1.34 | $1.34 |  | https://www.mouser.com/datasheet/3/72/1/KEM_A4148_A7D0.pdf
1 | L_{filter}1 | IND | 10 uH inductor; footprint unverified | Pulse Electronics | AMRM00101040100MA1 | Mouser | 673-AMRM101040100MA1 | $0.43 | $0.43 |  | https://www.mouser.com/datasheet/3/508/1/DATASHEET_AMRM00101040_SERIES.pdf
1 | U_{3V3DC}1 | IC | DC/DC converter; 12 V / 3.3 V conflict | XP Power | RBT05W24S3V3 | DigiKey | 1470-RBT05W24S3V3-ND | $2.39 | $2.39 |  | Price for schematic MPN; voltage conflict unresolved. USD, qty 1, excludes shipping/tax. https://www.digikey.com/en/products/detail/xp-power/RBT05W24S3V3/26667101 (https://www.mouser.com/catalog/specsheets/XPPOWER_05_13_2025_RBT05%20Series.pdf)
1 | U1 | IC | H-bridge driver; variant/package conflict | Texas Instruments | DRV8231DDAR | Spirit Electronics | DRV8231DDAR | $1.44 | $1.44 |  | Price for schematic MPN; variant/package conflict unresolved. USD, qty 1, excludes shipping/tax. https://spiritelectronics.com/shop/motor-drivers/drv8231ddar/ (https://www.ti.com/lit/ds/symlink/drv8231a.pdf)
13 | SW_{bypass}1, SW_{bypass}10, SW_{bypass}11, SW_{bypass}12, SW_{bypass}15, SW_{bypass}2, SW_{bypass}3, SW_{bypass}4, SW_{bypass}5, SW_{bypass}6, SW_{bypass}7, SW_{bypass}8, SW_{bypass}9 | SW | Normally-open push switch, 6 mm |  |  | Checkout |  | $0.00 | $0.00
1 | TFT2 | LCD | ST7735R TFT display | HiLetGo |  | Amazon |  | $0.00 | $0.00 |  | https://users.ece.utexas.edu/~valvano/mspm0/1-8-tft-display.pdf
1 | ESP8266 | ASM | ESP8266-1 Wi-Fi module |  |  | Valvano |  | $0.00 | $0.00 |  | https://www.microchip.ua/wireless/esp01.pdf
12 | M1, M10, M11, M12, M2, M3, M4, M5, M6, M7, M8, M9 | MOTOR | N20 gear motor, 3-6 V, 60 RPM | DORHEA |  | Amazon | B0DK74PVVN | $2.00 | $24.00 |  | https://www.amazon.com/dp/B0DK74PVVN
1 | M_{winch}1 | MOTOR | Launcher DC motor, 12 V | AUTOTOOLHOME |  | Amazon |  | $6.89 | $6.89 |  | https://www.amazon.com/dp/B01M58POHF?ref=ppx_yo2ov_dt_b_fed_asin_title
1 | M_{feeder}1 | SOL | Launcher solenoid | Heschen |  | Amazon |  | $13.00 | $13.00 |  | https://www.amazon.com/dp/B0HJLPS7FH?ref=ppx_yo2ov_dt_b_fed_asin_title
1 | J_{Keypad}1 | KEY | 4x4 matrix keypad, 8-pin |  |  | Valvano |  | $0.00 | $0.00
 |  |  | Serial USB to TTL CH340 | HiLetGo |  | Amazon | B00IJXZQ7C | $1.90 | $1.90 |  | Amazon.com: HiLetgo 5pcs USB to Serial USB to TTL CH340 Module with STC Microcontroller Download Adapter : Electronics (https://www.amazon.com/dp/B00LZV1G6K?lv=shuf&channelId=704&plpRedirect=mhFallback)
1 |  | ASM | Barcode scanner | Symcode |  | Amazon |  | $4.67 | $4.67 |  | Amazon.com : Symcode USB 1D Barcode Scanner, Handheld Wired CCD Laser Barcode Reader Scanner Supports Screen Scan UPC Bar Code Scanner for Warehouse, Library, Supermarket, POS : Office Products (https://www.amazon.com/dp/B0CSD8FP5W?lv=shuf&channelId=704&plpRedirect=mhFallback)
39 |  | LED | Red LEDs for product-outlet lighting |  |  | Checkout |  | $0.00 | $0.00 | Already owned
1 | F1 | FUSE-HLD | 5x20 mm fuse holder; fuse sold separately | Wurth Elektronik | 696108003002 | Mouser | 710-696108003002 | $0.67 | $0.67 | Order online | Datasheet (https://www.we-online.com/components/products/datasheet/696108003002.pdf) | Order (https://www.mouser.com/en/ProductDetail/Wurth-Elektronik/696108003002?qs=%252BEew9%252B0nqrCCQeoUrFurBg%3D%3D)
2 | J_{atomizer}1, J_{atomizer}2 | CON | Misters | Starry |  | Amazon |  | $2.50 | $5.00 | Order online | Amazon.com: 4Pcs USB Humidifier Module 5V Humidifieration Atomizer Spray Circuit | Ultrasonic Humidifier Board, Atomization Plate Disc Drive Board, DIY Home : Home & Kitchen (https://www.amazon.com/dp/B0FPFHWSSW?ref=fed_share)
1 |  |  | Type-C USB PD | Aceirmc |  | Amazon |  | $2.50 | $2.50 | Order online | Amazon.com: ACEIRMC 4pcs Type-C QC AFC PD2.0 PD3.0 to DC Fast Charge Decoy Trigger Polling Detector USB-PD Notebook Power Supply Change Board Module Support 5V 9V 12V 15V 20V Fixed Voltage Output : Electronics (https://www.amazon.com/dp/B0BTHXKM91)
13 | M1, M10, M11, M12, M2, M3, M4, M5, M6, M7, M8, M9, M_{winch}1 | CON | Motor connection, XT30U-M, 2-pin, 5 mm | AMASS | XT30U-M | Jameco | 2844415 | $0.55 | $7.15 | Order online | Datasheet (https://www.buzzardmodels.com/assets/images/Wiring%20and%20connectors/XT30U%20SPEC.pdf) | Order (https://www.jameco.com/z/XT30U-M-Amass-XT30-Plug-Male-15A-500V-2-Pin-Straight-Cable-Mount_2844415.html)
1 | M_{feeder}1 | CON | Solenoid connector, JST PH, 2-pin, 2 mm | JST | B2B-PH-K-S(LF)(SN) | DigiKey | 455-1704-ND | $0.12 | $0.12 | Order online | Datasheet (https://www.jst-mfg.com/product/pdf/eng/ePH.pdf) | Order (https://www.digikey.com/en/products/detail/jst-sales-america-inc/B2B-PH-K-S-LF-SN/926611)
 |  |  |  |  |  |  |  | Total Sum | $80.79
