tanai-prathapam/-lab7_445L_personal/sw/src/MSPM0_Pins_AssignmentsLab7.xlsx

Sheet: VSSOP-32
M0G3507QDGS32RQ1 |  | Pin | Pin
Keypad Output | PA26 | 1 | 32 | PA25 | ST7735R CARD_CS
ST7735R TFT_CS | PA27 | 2 | 31 | PA24 | ST7735R Reset
 | Vcore | 3 | 30 | PA23 | Keypad Output
Keypad Input | PA0 | 4 | 29 | PA22 | UART2_RX
Keypad Input | PA1 | 5 | 28 | PA21 | UART2_TX
 | NRST | 6 | 27 | PA20 | SWCLK
 | Vdd | 7 | 26 | PA19 | SWDIO
 | Vss | 8 | 25 | PA18 | ST7735R SPI1 MOSI
Keypad Input | PA2 | 9 | 24 | PA17 | ST7735R SPI1 SCK
Keypad Input | PA3 | 10 | 23 | PA16 | Solenoid
Keypad Output | PA4 | 11 | 22 | PA15 | DACOUT/Buzzer
HFXIN | PA5 | 12 | 21 | PA14 | Motor 1
HFXOUT | PA6 | 13 | 20 | PA13 | ST7735R D/C
Keypad Output | PA7 | 14 | 19 | PA12 | Motor 2
UART1_TX | PA8 | 15 | 18 | PA11 | Motor 3
UART1_RX | PA9 | 16 | 17 | PA10 | Motor 4
Available pins = | 26
Notes
PA0 and PA1 are open drain (only go low, not high)

Sheet: VSSOP-32 x2
Master Controller |  | Pin | Pin |  |  | Key:
Keypad Input 4 | PA26 | 1 | 32 | PA25 | ESP8266 Reset | Keypad
ST7735R TFT_CS | PA27 | 2 | 31 | PA24 | ST7735R Reset | Screen
 | Vcore | 3 | 30 | PA23 | Keypad Input 3 | SPI - uC
Keypad Output 1 | PA0 | 4 | 29 | PA22 | UART2_RX - ESP32 | Electromech
Keypad Output 2 | PA1 | 5 | 28 | PA21 | UART2_TX - ESP32 | Speaker
NC | NRST | 6 | 27 | PA20 | SWCLK | Wifi Module
+3V3 | Vdd | 7 | 26 | PA19 | SWDIO | ID Reader
GND | Vss | 8 | 25 | PA18 | ST7735R SPI1 MOSI | Flash
uC - SPI0_CS0 | PA2 | 9 | 24 | PA17 | ST7735R SPI1 SCK | 80MHz SiO2
Keypad Output 3 | PA3 | 10 | 23 | PA16 | ESP8266 GPIO2 | Other
Keypad Input 1 | PA4 | 11 | 22 | PA15 | DACOUT/Buzzer | NC/Free
HFXIN | PA5 | 12 | 21 | PA14 | SPI0_PICO - uC | Power
HFXOUT | PA6 | 13 | 20 | PA13 | ST7735R D/C | Unused
Keypad Input 2 | PA7 | 14 | 19 | PA12 | SPI0_SCK - uC
ID Reader - UART1_TX | PA8 | 15 | 18 | PA11 | Keypad Output 4
ID Reader - UART1_RX | PA9 | 16 | 17 | PA10 | SPI0_POCI - uC
Free Pins: 0
Slave Controller |  | Pin | Pin
Motor 1 | PA26 | 1 | 32 | PA25 | ST7735R CARD_CS
ST7735R TFT_CS | PA27 | 2 | 31 | PA24 | ST7735R Reset
 | Vcore | 3 | 30 | PA23 | Motor 2
Motor PWM | PA0 | 4 | 29 | PA22 | Winch+
Smoke Enable | PA1 | 5 | 28 | PA21 | Winch-
NC | NRST | 6 | 27 | PA20 | SWCLK
+3V3 | Vdd | 7 | 26 | PA19 | SWDIO
GND | Vss | 8 | 25 | PA18 | ST7735R SPI1 MOSI
uC - SPI0_CS0 | PA2 | 9 | 24 | PA17 | ST7735R SPI1 SCK
LED Group 1 | PA3 | 10 | 23 | PA16 | ST7735R SPI1 MISO
uC - SPI0_POCI | PA4 | 11 | 22 | PA15 | DACOUT/Buzzer
HFXIN | PA5 | 12 | 21 | PA14 | LED Group 3
HFXOUT | PA6 | 13 | 20 | PA13 | ST7735R D/C
LED Group 2 | PA7 | 14 | 19 | PA12 | Solenoid
Motor 3 | PA8 | 15 | 18 | PA11 | SPI0_SCK - uC
uC - SPI0_PICO | PA9 | 16 | 17 | PA10 | Motor 4
Free Pins: 3
S

Sheet: BOM
 |  |  |  |  |  |  |  | Total (mA) |  | Total ($)
 |  |  |  |  |  |  |  | 36.135 |  | $83.68
quantity | Designator | Description | Footprint | Manufacturer | Part Number | Distributor | Dist Part number | Current (mA) | Unit | Cost
2 | C1 C2 | 4.7uF tantalum | 0.2in |  |  | Digikey | 478-1904-ND |  | $0.74 | $1.48
2 | C3,C5 | 1.0uF Ceramic | 0.1in 2.5mm | TDKZ | FG18X5R1H105KRT00 | Mouser | 810-FG18X5R1H105KRT0 |  | $0.11 | $0.22
1 | C4 | 10nF Ceramic | 0.1in 2.5mm |  |  | Digikey | 399-4148-ND |  | $0.30 | $0.30
2 | C6 C8 | 0.1uF ceramic | 0.1in 2.5mm |  |  | Digikey | 399-4151-ND |  | $0.36 | $0.72
1 | C7 | 10uF Ceramic, X7R, 10% 10V | 0.1in 2.5mm | TDK | FG14X7R1A106KRT06 | Mouser | 810-FG14X7R1A106KRT6 |  | $0.21 | $0.21
1 | C9 | 0.47uF ceramic | 0.1in 2.5mm |  |  | Digikey | 399-4309-ND |  | $0.46 | $0.46
2 | C10 C11 | 10pF C0G 5% | 0.1in 2.5mm |  | FG18C0G1H100DNT06 | Mouser | 810-FG18C0G1H100DNT6 |  | $0.22 | $0.44
0 |  | 22pF C0G 5% | 0.1in 2.5mm | TDK | FG18C0G1H220JNT06 | Mouser | 810-FG18C0G1H220JNT6 |  | $0.22 | $0.00
1 | Q1 | N-channel MOSFET | SOT-23 | Onsemi | NTR4501NT1G | Mouser | 863-NTR4501NT1G |  | $0.46 | $0.46
1 | Y1 | 16.000000MHz crystal | 5mm by 3.2mm | NDK | LNCD1-16M | Mouser | 344-NX5032GA16MLNCD1 |  | $1.24 | $1.24 | NDK | NX5032GA-16.000000 | Digikey | 644-LNCD1-16MCT-ND
0 |  | 40.0000MHz crystal | 2mm by 2.5mm | Epson Timing | FA-20H 40.0000MF10Z-W3 | Mouser | 732-FA-20H40MF10Z-W3 |  | $0.79 | $0.00
1 | U1 | 18-bit color 128*160 1.8" TFT LCD display | 1 by 10 0.1in | Sitronix | ST7735R | Adafruit | 358 | 25 | $20.00 | $20.00
1 | U2 | LP2950 3.3V regulator, 100 mA | TO-92 | TI | LP2950-33LPRE3 | Mouser | 595-LP2950-33LPRE3 | 0.05 | $0.65 | $0.65
1 | U3 | MSPM0G3507 | 32-pin VSSOP | TI | M0G3507QDGS32RQ1 | Mouser | 595-M0G3507QDGS32RQ1 | 8 | $2.70 | $2.70
1 |  | +3V SINGLE SUPPLY DAC | SOIC-9 | Analog Devices | AD8300ARZ | Mouser | 584-AD8300ARZ | 1.7 | $29.81 | $29.81
1 | U6 | LOW PWR RAIL/RAIL OP AMP | SOIC-8 | Analog Devices | AD8542ARZ-REEL7 | Mouser | 584-AD8542ARZ-R7 | 0.055 | $1.57 | $1.57
2 | D1 D2 | Red 1.6V 1mA 5mm diffused | 5mm | Avago Technologies | HLMP-D150 | Mouser | 630-HLMP-D150 | 1 | $0.60 | $1.20
1 | D3 | 1N914 |  | Fairchild | 1N914B | Mouser | 512-1N914B
1 | RV1 | Slide pot, 10k | 2cm | Bourns , | PTA2043-2015CPB103 | Mouser | 652-PTA20432015CPB10 | 0.33 | $1.73 | $1.73
2 | R1 R2 | 470 ohm | 7.62mm | Yageo | CFR-12JB-470R | Digikey | 470EBK-ND |  | $0.10 | $0.20
1 | R3 | 47k | 7.62mm | Yageo | CFR-12JB-47K | Digikey | 47KEBK-ND |  | $0.10 | $0.10
2 | R4 R6 | 10k | 7.62mm | Yageo | CFR-12JB-10K | Digikey | 10KEBK-ND |  | $0.10 | $0.20
1 | R5 | 20k | 7.62mm | Yageo | CFR-12JB-20K | Digikey | 20KEBK-ND |  | $0.10 | $0.10
0 | R7 | 100k | 7.62mm | Yageo | CFR-12JB-100K | Digikey | 100KEBK-ND |  | $0.10 | $0.00
5 | SW1 SW2 SW3 SW4 SW5 | B3F tactile switch, white |  | Omron | B3F-1050 | Mouser | 653-B3F-1050 |  | $0.37 | $1.85
1 | J1 | 2-pin header for power | JST 1.25
1 | J2 | 2-pin header for buzzer
1 | J3 | 2-pin header for speaker
1 | J4 | 4-pin header for debugger
1 | J5 | micro USB connector |  | Hirose Connector | ZX62D-B-5PA8_30_ | Mouser | 798-ZX62D-B-5PA830 |  | $0.79 | $0.79
1 | box | Enclosures, 3.25x5.63x1.51in |  | Serpac | 151,BK | Mouser | 635-151-B |  | $12.50 | $12.50
1 | battery | 3.7V 1100mAh Flat Rechargeable Battery | JST 1.25 | MakerFocus |  | Amazon |  |  | $4.75 | $4.75

Sheet: TMP63
Vbias (V) | 3.3 |  | Slope | 337 |  |  | T = 2500+((n-2048)*2500)/337 | n | Fixed
ADC | 4096 |  | Range | 25 |  |  |  | 1833 | 905
Rbias (kohm) | 10 |  |  |  |  |  |  | 1834 | 912
Temperature | Resistance | Vtemp | ADC0_5 | Fit | Fixed | error | software | 1835 | 920
10 | 8.10 | 1.48 | 1833 | 9.05 | 905 | 0.95 | 905 | 1836 | 927
25 | 10.00 | 1.65 | 2048 | 25.00 | 2500 | 0.00 | 2500 | 1837 | 935
35 | 11.27 | 1.75 | 2170 | 34.05 | 3405 | 0.95 | 3405 | 1838 | 942
 |  |  |  |  |  |  |  | 1839 | 950
 |  |  |  |  |  |  |  | 1840 | 957
 |  |  |  |  |  |  |  | 1841 | 964
 |  |  |  |  |  |  |  | 1842 | 972
 |  |  |  |  |  |  |  | 1843 | 979
 |  |  |  |  |  |  |  | 1844 | 987
 |  |  |  |  |  |  |  | 1845 | 994
 |  |  |  |  |  |  |  | 1846 | 1001
 |  |  |  |  |  |  |  | 1847 | 1009
 |  |  |  |  |  |  |  | 1848 | 1016
 |  |  |  |  |  |  |  | 1849 | 1024
 |  |  |  |  |  |  |  | 1850 | 1031
 |  |  |  |  |  |  |  | 1851 | 1039
 |  |  |  |  |  |  |  | 1852 | 1046
 |  |  |  |  |  |  |  | 1853 | 1053
 |  |  |  |  |  |  |  | 1854 | 1061
 |  |  |  |  |  |  |  | 1855 | 1068
 |  |  |  |  |  |  |  | 1856 | 1076
 |  |  |  |  |  |  |  | 1857 | 1083
 |  |  |  |  |  |  |  | 1858 | 1091
 |  |  |  |  |  |  |  | 1859 | 1098
 |  |  |  |  |  |  |  | 1860 | 1105
 |  |  |  |  |  |  |  | 1861 | 1113
 |  |  |  |  |  |  |  | 1862 | 1120
 |  |  |  |  |  |  |  | 1863 | 1128
 |  |  |  |  |  |  |  | 1864 | 1135
 |  |  |  |  |  |  |  | 1865 | 1142
 |  |  |  |  |  |  |  | 1866 | 1150
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
 |  |  |  |  |  |  |  | 2150 | 3257
 |  |  |  |  |  |  |  | 2151 | 3264
 |  |  |  |  |  |  |  | 2152 | 3272
 |  |  |  |  |  |  |  | 2153 | 3279
 |  |  |  |  |  |  |  | 2154 | 3286
 |  |  |  |  |  |  |  | 2155 | 3294
 |  |  |  |  |  |  |  | 2156 | 3301
 |  |  |  |  |  |  |  | 2157 | 3309
 |  |  |  |  |  |  |  | 2158 | 3316
 |  |  |  |  |  |  |  | 2159 | 3323
 |  |  |  |  |  |  |  | 2160 | 3331
 |  |  |  |  |  |  |  | 2161 | 3338
 |  |  |  |  |  |  |  | 2162 | 3346
 |  |  |  |  |  |  |  | 2163 | 3353
 |  |  |  |  |  |  |  | 2164 | 3361
 |  |  |  |  |  |  |  | 2165 | 3368
 |  |  |  |  |  |  |  | 2166 | 3375
 |  |  |  |  |  |  |  | 2167 | 3383

Sheet: Timers
 |  | ULPCLK | Power Domain
SysTick | 24 bit | 80MHz
TimerA0 | 16 bit, 8 bit prescaler | 80MHz | PD1
TimerA1 | 16 bit, 8 bit prescaler | 80MHz | PD1
TimerG0 | 16 bit, 8 bit prescaler | 40MHz | PD0
TimerG12 | 32 bit | 80MHz | PD1
TimerG6 | 16 bit, 8 bit prescaler | 80MHz | PD1
TimerG7 | 16 bit, 8 bit prescaler | 80MHz | PD1
TimerG8 | 16 bit, 8 bit prescaler | 40MHz | PD0

Sheet: ADC
ADC0
 | ADC0_0 | PA27
 | ADC0_1 | PA26
 | ADC0_2 | PA25
 | ADC0_3 | PA24
 | ADC0_7 | PA22
ADC1
 | ADC1_0 | PA15
 | ADC1_1 | PA16
 | ADC1_2 | PA17
 | ADC1_3 | PA18
 | ADC1_7 | PA21
 | ADC1_12 | PA14

Sheet: PINCM
PINCM | Pin | Mode2 | Mode3 | Mode4 | Mode5 | Mode6 | Mode7 | Mode8 | Mode9
1 | PA0 | UART0_TX | I2C0_SDA | TIMA0_C0 | TIMA_FAL1 | TIMG8_C1 | FCC_IN
2 | PA1 | UART0_RX | I2C0_SCL | TIMA0_C1 | TIMA_FAL2 | TIMG8_IDX | TIMG8_C0
7 | PA2 | TIMG8_C1 | SPI0_CS0 | TIMG7_C1 | SPI1_CS0
8 | PA3 | TIMG8_C0 | SPI0_CS1 | UART2_CTS | TIMA0_C2 | COMP1_OUT | TIMG7_C0 | TIMA0_C1 | I2C1_SDA
9 | PA4 | TIMG8_C1 | SPI0_POCI | UART2_RTS | TIMA0_C3 | LFCLK_IN | TIMG7_C1 | TIMA0_C1N | I2C1_SCL
10 | PA5 | TIMG8_C0 | SPI0_PICO | TIMA_FAL1 | TIMG0_C0 | TIMG6_C0 | FCC_IN
11 | PA6 | TIMG8_C1 | SPI0_SCK | TIMA_FAL0 | TIMG0_C1 | HFCLK_IN | TIMG6_C1 | TIMA0_C2N
14 | PA7 | COMP0_OUT | CLK_OUT | TIMG8_C0 | TIMA0_C2 | TIMG8_IDX | TIMG7_C1 | TIMA0_C1
19 | PA8 | UART1_TX | SPI0_CS0 | UART0_RTS | TIMA0_C0 | TIMA1_C0N
20 | PA9 | UART1_RX | SPI0_PICO | UART0_CTS | TIMA0_C1 | RTC_OUT | TIMA0_C0N | TIMA1_C1N | CLK_OUT
21 | PA10 | UART0_TX | SPI0_POCI | I2C0_SDA | TIMA1_C0 | TIMG12_C0 | TIMA0_C2 | I2C1_SDA | CLK_OUT
22 | PA11 | UART0_RX | SPI0_SCK | I2C0_SCL | TIMA1_C1 | COMP0_OUT | TIMA0_C2N | I2C1_SCL
34 | PA12 | UART3_CTS | SPI0_SCK | TIMG0_C0 | CAN_TX | TIMA0_C3 | FCC_IN
35 | PA13 | UART3_RTS | SPI0_POCI | UART3_RX | TIMG0_C1 | CAN_RX | TIMA0_C3N
36 | PA14 | UART0_CTS | SPI0_PICO | UART3_TX | TIMG12_C0 | CLK_OUT
37 | PA15 | UART0_RTS | SPI1_CS2 | I2C1_SCL | TIMA1_C0 | TIMG8_IDX | TIMA1_C0N | TIMA0_C2
38 | PA16 | COMP2_OUT | SPI1_POCI | I2C1_SDA | TIMA1_C1 | TIMA1_C1N | TIMA0_C2N | FCC_IN
39 | PA17 | UART1_TX | SPI1_SCK | I2C1_SCL | TIMA0_C3 | TIMG7_C0 | TIMA1_C0
40 | PA18 | UART1_RX | SPI1_PICO | I2C1_SDA | TIMA0_C3N | TIMG7_C1 | TIMA1_C1
41 | PA19 | SWDIO
42 | PA20 | SWCLK
46 | PA21 | UART2_TX | TIMG8_C0 | UART1_CTS | TIMA0_C0 | TIMG6_C0
47 | PA22 | UART2_RX | TIMG8_C1 | UART1_RTS | TIMA0_C1 | CLK_OUT | TIMA0_C0N | TIMG6_C1
53 | PA23 | UART2_TX | SPI0_CS3 | TIMA0_C3 | TIMG0_C0 | UART3_CTS | TIMG7_C0 | TIMG8_C0
54 | PA24 | UART2_RX | SPI0_CS2 | TIMA0_C3N | TIMG0_C1 | UART3_RTS | TIMG7_C1 | TIMA1_C1
55 | PA25 | UART3_RX | SPI1_CS3 | TIMG12_C1 | TIMA0_C3 | TIMA0_C1N
59 | PA26 | UART3_TX | SPI1_CS0 | TIMG8_C0 | TIMA_FAL0 | CAN_TX | TIMG7_C0
60 | PA27 | RTC_OUT | SPI1_CS1 | TIMG8_C1 | TIMA_FAL2 | CAN_RX | TIMG7_C1
3 | PA28 | UART0_TX | I2C0_SDA | TIMA0_C3 | TIMA_FAL0 | TIMG7_C0 | TIMA1_C0
4 | PA29 | I2C1_SCL | UART2_RTS | TIMG8_C0 | TIMG6_C0
5 | PA30 | I2C1_SDA | UART2_CTS | TIMG8_C1 | TIMG6_C1
6 | PA31 | UART0_RX | I2C0_SCL | TIMA0_C3N | TIMG12_C1 | CLK_OUT | TIMG7_C1 | TIMA1_C1
12 | PB0 | UART0_TX | SPI1_CS2 | TIMA1_C0 | TIMA0_C2
13 | PB1 | UART0_RX | SPI1_CS3 | TIMA1_C1 | TIMA0_C2N
15 | PB2 | UART3_TX | UART2_CTS | I2C1_SCL | TIMA0_C3 | UART1_CTS | TIMG6_C0 | TIMA1_C0
16 | PB3 | UART3_RX | UART2_RTS | I2C1_SDA | TIMA0_C3N | UART1_RTS | TIMG6_C1 | TIMA1_C1
17 | PB4 | UART1_TX | UART3_CTS | TIMA1_C0 | TIMA0_C2 | TIMA1_C0N
18 | PB5 | UART1_RX | UART3_RTS | TIMA1_C1 | TIMA0_C2N | TIMA1_C1N
23 | PB6 | UART1_TX | SPI1_CS0 | SPI0_CS1 | TIMG8_C0 | UART2_CTS | TIMG6_C0 | TIMA1_C0N
24 | PB7 | UART1_RX | SPI1_POCI | SPI0_CS2 | TIMG8_C1 | UART2_RTS | TIMG6_C1 | TIMA1_C1N
25 | PB8 | UART1_CTS | SPI1_PICO | TIMA0_C0 | COMP1_OUT
26 | PB9 | UART1_RTS | SPI1_SCK | TIMA0_C1 | TIMA0_C0N
27 | PB10 | TIMG0_C0 | TIMG8_C0 | COMP1_OUT | TIMG6_C0
28 | PB11 | TIMG0_C1 | TIMG8_C1 | CLK_OUT | TIMG6_C1
29 | PB12 | UART3_TX | TIMA0_C2 | TIMA_FAL1 | TIMA0_C1
30 | PB13 | UART3_RX | TIMA0_C3 | TIMG12_C0 | TIMA0_C1N
31 | PB14 | SPI1_CS3 | SPI1_POCI | SPI0_CS3 | TIMG12_C1 | TIMG8_IDX | TIMA0_C0
32 | PB15 | UART2_TX | SPI1_PICO | UART3_CTS | TIMG8_C0 | TIMG7_C0
33 | PB16 | UART2_RX | SPI1_SCK | UART3_RTS | TIMG8_C1 | TIMG7_C1
43 | PB17 | UART2_TX | SPI0_PICO | SPI1_CS1 | TIMA1_C0 | TIMA0_C2
44 | PB18 | UART2_RX | SPI0_SCK | SPI1_CS2 | TIMA1_C1 | TIMA0_C2N
45 | PB19 | COMP2_OUT | SPI0_POCI | TIMG8_C1 | UART0_CTS | TIMG7_C1
48 | PB20 | SPI0_CS2 | SPI1_CS0 | TIMA0_C2 | TIMG12_C0 | TIMA_FAL1 | TIMA0_C1 | TIMA1_C1N
49 | PB21 | SPI1_POCI | TIMG8_C0
50 | PB22 | SPI1_PICO | TIMG8_C1
51 | PB23 | SPI1_SCK | COMP0_OUT | TIMA_FAL0
52 | PB24 | SPI0_CS3 | SPI0_CS1 | TIMA0_C3 | TIMG12_C1 | TIMA0_C1N | TIMA1_C0N
56 | PB25 | UART0_CTS | SPI0_CS0 | TIMA_FAL2
57 | PB26 | UART0_RTS | SPI0_CS1 | TIMA0_C3 | TIMG6_C0 | TIMA1_C0
58 | PB27 | COMP2_OUT | SPI1_CS1 | TIMA0_C3N | TIMG6_C1 | TIMA1_C1
