tanai-prathapam/-lab7_445L_personal/Datasheets.xlsx

Part Name | Part/SKU No. | Datasheet link
MSPM0G350 | MSPM0G3507 | https://www.ti.com/lit/ds/symlink/mspm0g3507-q1.pdf?ts=1792449032891
