tanai-prathapam/-lab7_445L_personal/hw/ECE445L_Lab7/CAD/coil.3mf

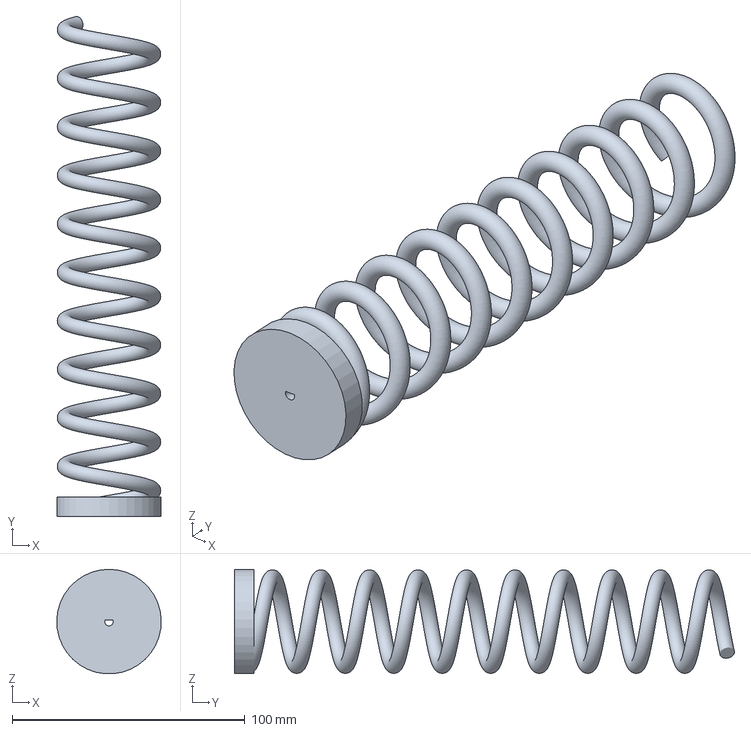
[picture p3: CAD file, 2026-11-07]
hw/ECE445L_Lab7/CAD/coil.3mf
44.9 x 214.7 x 44.8 mm
