tanai-prathapam/-lab7_445L_personal/hw/Part Libraries/models/Part Libraries/models/N7803-2C.stp

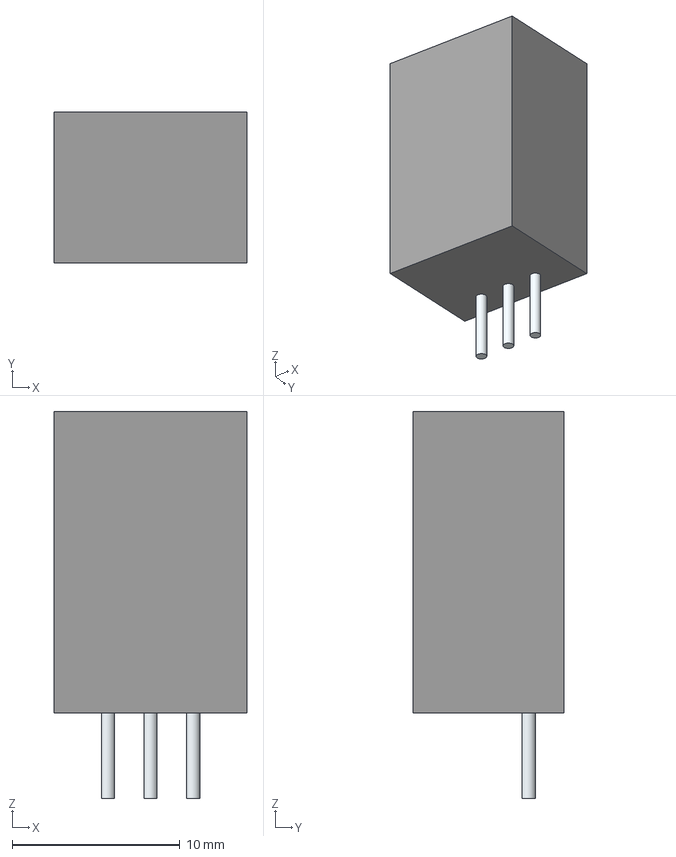
[picture p4: CAD file, 2026-11-03]
hw/Part Libraries/models/Part Libraries/models/N7803-2C.stp
11.5 x 9.00 x 23.1 mm
Leads
