tanai-prathapam/-lab7_445L_personal/hw/Part Libraries/models/Part Libraries/models/SOIC-24WB_ONS.step

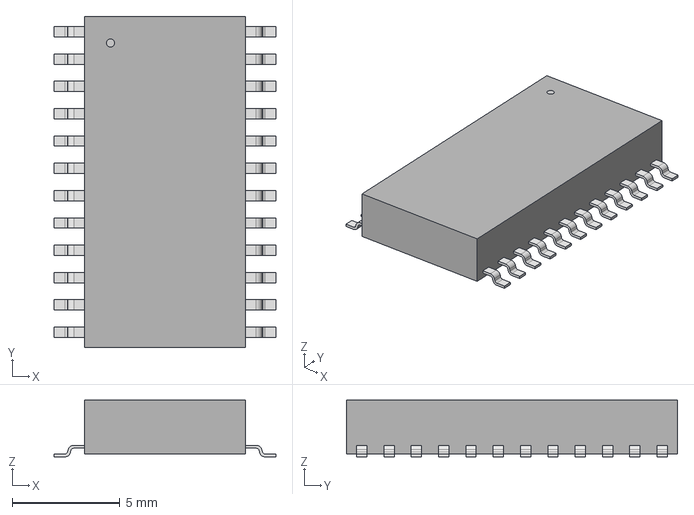
[picture p5: CAD file, 2026-10-30]
hw/Part Libraries/models/Part Libraries/models/SOIC-24WB_ONS.step
10.3 x 15.4 x 2.64 mm
