tanai-prathapam/-lab7_445L_personal/hw/Part Libraries/models/Part Libraries/models/NTR4501NT1G.stp

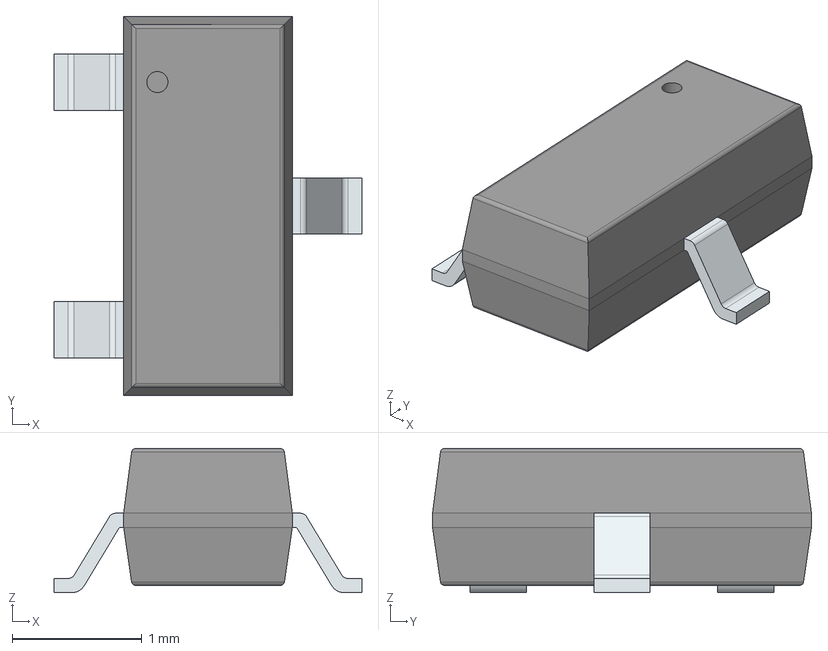
[picture p6: CAD file, 2026-10-30]
hw/Part Libraries/models/Part Libraries/models/NTR4501NT1G.stp
2.37 x 2.92 x 1.11 mm
PinsArrayL
FilletPinR
