tanai-prathapam/-lab7_445L_personal/hw/ECE445L_Lab7/ECE445L_Lab7.kicad_pcb

## KiCad design hw/ECE445L_Lab7/ECE445L_Lab7.kicad_pcb (2026-11-03)

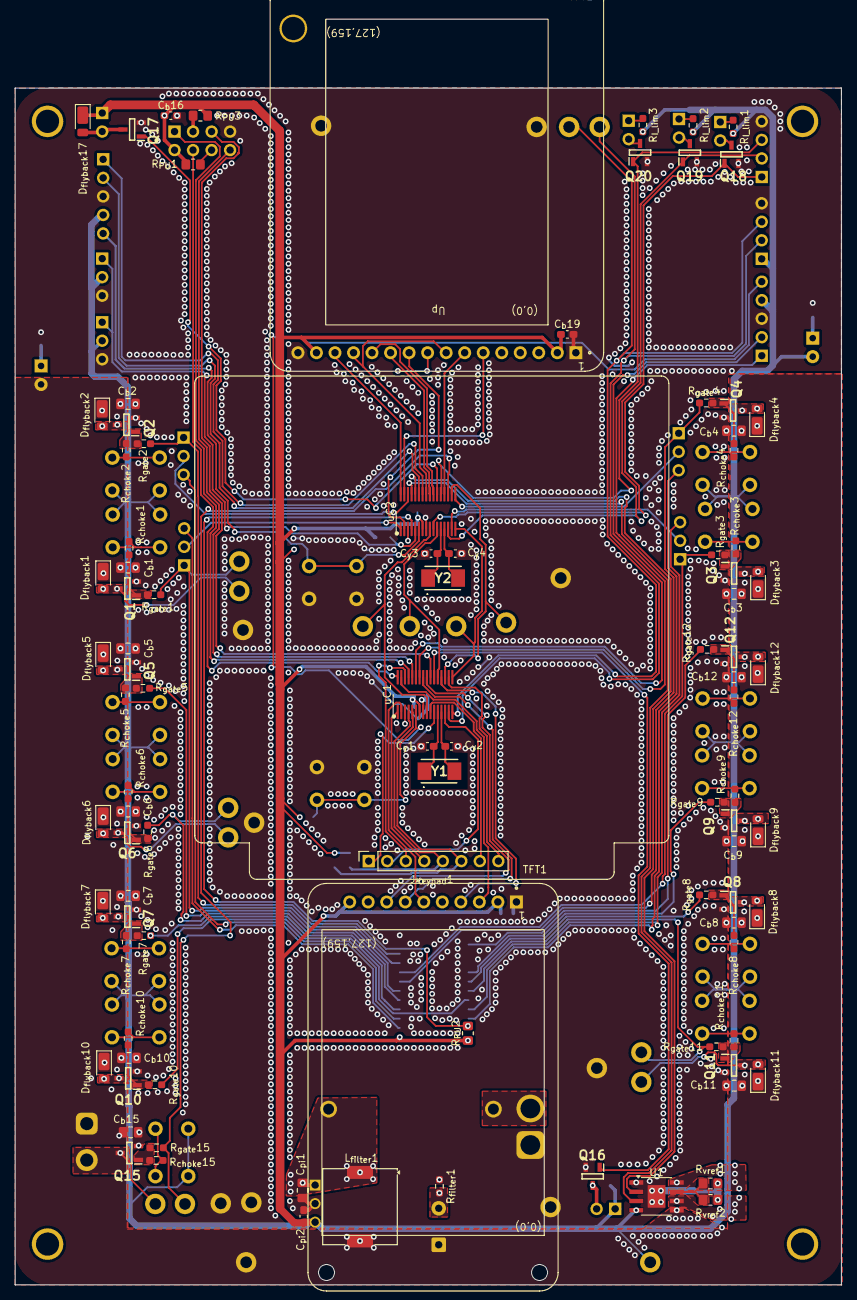
[picture p7: board ECE445L_Lab7.kicad_pcb from above]

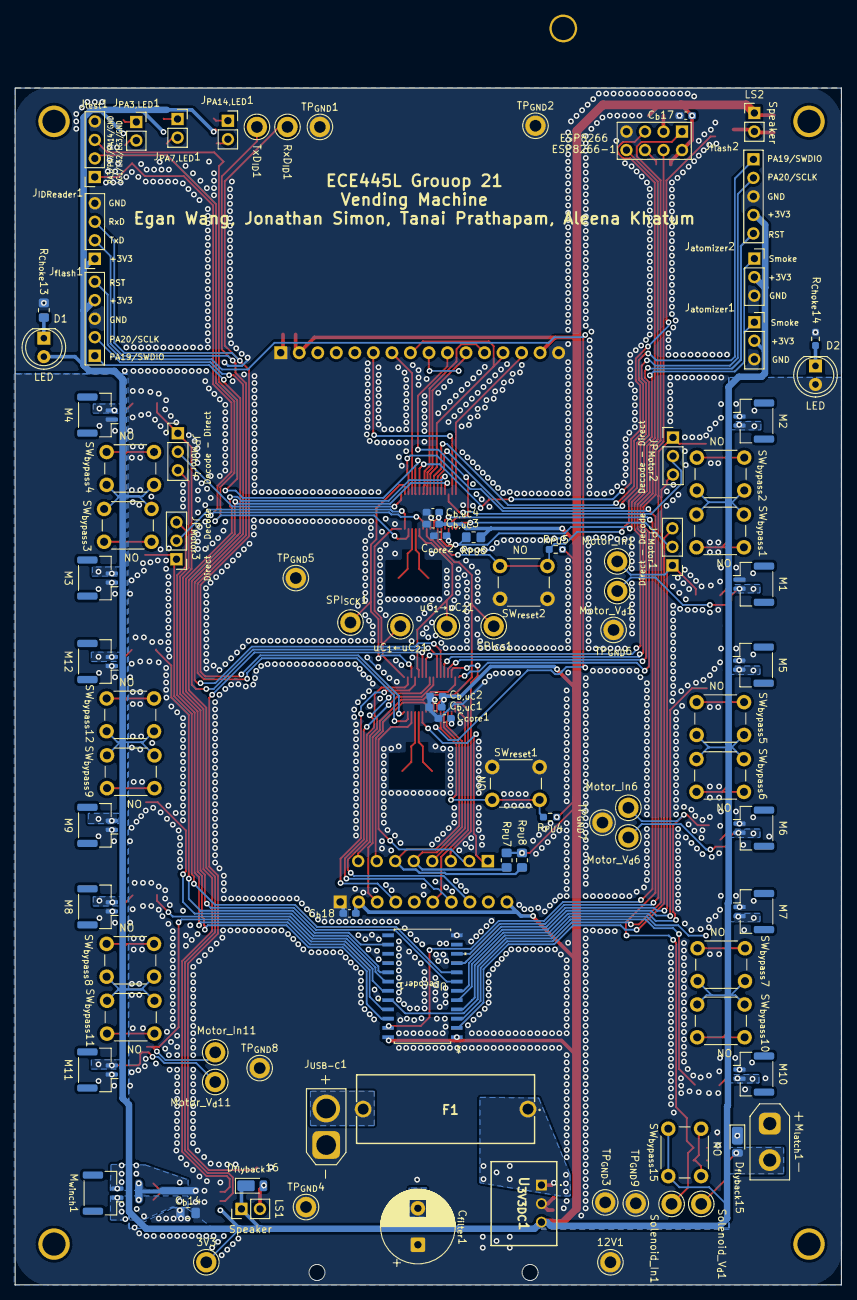
[picture p8: board ECE445L_Lab7.kicad_pcb from below]

Board: 2 copper layers, 113.3 x 164.1 mm, 195 parts (95 on the bottom side), 132 nets.

Parts:
3V3, 12V1: TestPoint; TestPoint_Keystone_5010-5014_Multipurpose
C_{b,uC}1, C_{b,uC}3: 100n; C_0603_1608Metric_Pad1.08x0.95mm_HandSolder
C_{b,uC}2, C_{b,uC}4: 10u; C_0603_1608Metric_Pad1.08x0.95mm_HandSolder
C_{b}1, C_{b}2, C_{b}3, C_{b}4, C_{b}5, C_{b}6, C_{b}7, C_{b}8, C_{b}9, C_{b}10, C_{b}11, C_{b}12, C_{b}14, C_{b}15: 4.7u; C_0805_2012Metric_Pad1.18x1.45mm_HandSolder
C_{b}16: 100n; C_0603_1608Metric_Pad1.08x0.95mm_HandSolder
C_{b}17, C_{b}18, C_{b}19: 4.7u; C_0603_1608Metric_Pad1.08x0.95mm_HandSolder
C_{core}1, C_{core}2: 0.47u; C_0603_1608Metric_Pad1.08x0.95mm_HandSolder
C_{filter}1: 1200u; CP_Radial_D10.0mm_P5.00mm
C_{pi}1: 4.7u; C_0805_2012Metric_Pad1.18x1.45mm_HandSolder
C_{pi}2: 4.7u; C_0603_1608Metric_Pad1.08x0.95mm_HandSolder
C_{y}1, C_{y}2, C_{y}3, C_{y}4: 10p; C_0603_1608Metric_Pad1.08x0.95mm_HandSolder
D1, D2: LED; LED_D5.0mm
D_{flyback}1, D_{flyback}2, D_{flyback}3, D_{flyback}4, D_{flyback}5, D_{flyback}6, D_{flyback}7, D_{flyback}8, D_{flyback}9, D_{flyback}10, D_{flyback}11, D_{flyback}12, D_{flyback}15, D_{flyback}16, D_{flyback}17: DFLS240LX-7; D_PowerDI-123
ESP8266: ESP8266-1; PinHeader_2x04_P2.54mm_Vertical
F1: Fuse; WR-FSH_THT_2
H1, H2, H3, H4: MountingHole_4_40
JP_{Motor}1, JP_{Motor}2, JP_{Motor}3, JP_{Motor}4: Jumper_3_Open; PinHeader_1x03_P2.54mm_Vertical
J_{IDReader}1: Conn_01x04; PinSocket_1x04_P2.54mm_Vertical
J_{Keypad}1: Conn_01x08; 4x4_Matrix_Keypad
J_{PA3,LED}1, J_{PA7,LED}1, J_{PA14,LED}1: Conn_01x02; PinSocket_1x02_P2.54mm_Vertical
J_{USB-C}1: Conn_01x02; AMASS_XT30U-M_1x02_P5.0mm_Vertical
J_{atomizer}1, J_{atomizer}2: Conn_01x03; PinSocket_1x03_P2.54mm_Vertical
J_{flash}1: J_{flash}1; PinHeader_1x05_P2.54mm_Vertical
J_{flash}2: J_{flash}2; PinHeader_1x05_P2.54mm_Vertical
J_{test}1: Conn_02x04_Counter_Clockwise; PinSocket_1x04_P2.54mm_Vertical
LS1, LS2: Speaker; PinHeader_1x02_P2.54mm_Vertical
L_{filter}1: 10uH; L_Coilcraft_MSS1038-XXX
M1, M2, M3, M4, M5, M6, M7, M8, M9, M10, M11, M12: Motor_DC; JST_GH_BM02B-GHS-TBT_1x02-1MP_P1.25mm_Vertical
M_{latch}1: Solenoid; AMASS_XT30UPB-F_1x02_P5.0mm_Vertical
M_{winch}1: Motor_DC; JST_GH_BM02B-GHS-TBT_1x02-1MP_P1.25mm_Vertical
Motor_In1, Motor_In6, Motor_In11: TestPoint; TestPoint_Keystone_5010-5014_Multipurpose
Motor_V_{d}1, Motor_V_{d}6, Motor_V_{d}11: TestPoint; TestPoint_Keystone_5010-5014_Multipurpose
Q1, Q2, Q3, Q4, Q5, Q6, Q7, Q8, Q9, Q10, Q11, Q12, Q15, Q16, Q17, Q18, Q19, Q20: NTR4501NT1G; SOT96P237X111-3N
R_{Choke}13: 10k; R_0805_2012Metric_Pad1.20x1.40mm_HandSolder
R_{Choke}14: 36.5k; R_0603_1608Metric_Pad0.98x0.95mm_HandSolder
R_{I_lim}1, R_{I_lim}2, R_{I_lim}3: R; R_0603_1608Metric_Pad0.98x0.95mm_HandSolder
R_{PU}1, R_{PU}2, R_{PU}3, R_{PU}6, R_{PU}7, R_{PU}8: 10k; R_0805_2012Metric_Pad1.20x1.40mm_HandSolder
R_{PU}4, R_{PU}5: 10k; R_0603_1608Metric_Pad0.98x0.95mm_HandSolder
R_{choke}1, R_{choke}2, R_{choke}3, R_{choke}4, R_{choke}5, R_{choke}6, R_{choke}7, R_{choke}8, R_{choke}9, R_{choke}10, R_{choke}11, R_{choke}12, R_{choke}15: 680; R_0603_1608Metric_Pad0.98x0.95mm_HandSolder
R_{filter}1: 0.25; R_0603_1608Metric_Pad0.98x0.95mm_HandSolder
R_{gate}1, R_{gate}2, R_{gate}3, R_{gate}4, R_{gate}5, R_{gate}6, R_{gate}7, R_{gate}8, R_{gate}9, R_{gate}10, R_{gate}11, R_{gate}12, R_{gate}15: 0.25; R_0603_1608Metric_Pad0.98x0.95mm_HandSolder
R_{vref}1, R_{vref}2: 264m; R_0805_2012Metric_Pad1.20x1.40mm_HandSolder
RxD_{ID}1: TestPoint; TestPoint_Keystone_5010-5014_Multipurpose
SPI_{CS}1: TestPoint; TestPoint_Keystone_5010-5014_Multipurpose
SPI_{SCK}1: TestPoint; TestPoint_Keystone_5010-5014_Multipurpose
SW_{bypass}1, SW_{bypass}2, SW_{bypass}3, SW_{bypass}4, SW_{bypass}5, SW_{bypass}6, SW_{bypass}7, SW_{bypass}8, SW_{bypass}9, SW_{bypass}10, SW_{bypass}11, SW_{bypass}12, SW_{bypass}15: NO; SW_PUSH_6mm
SW_{reset}1, SW_{reset}2: NO; SW_PUSH_6mm
Solenoid_In1: TestPoint; TestPoint_Keystone_5010-5014_Multipurpose
Solenoid_V_{d}1: TestPoint; TestPoint_Keystone_5010-5014_Multipurpose
TFT1: Adafruit ST7735R; adafruit_st7735r2
TFT2: HiLetGo_ST7735R; hiletgo_st7735r2
TP_{GND}1, TP_{GND}2, TP_{GND}3, TP_{GND}4, TP_{GND}5, TP_{GND}6, TP_{GND}7, TP_{GND}8, TP_{GND}9: TestPoint; TestPoint_Keystone_5010-5014_Multipurpose
TxD_{ID}1: TestPoint; TestPoint_Keystone_5010-5014_Multipurpose
U1: DRV8231ADSG; TI_SO-PowerPAD-8
U_{3V3DC}1: N7803-2C; N78032C
U_{Decoder}1: MC14514BDWR2G; SOIC-24WB_ONS
Y1, Y2: 16MHz; ABM3
uC1, uC2: M0G3507QDGS32RQ1; VSSOP_0.5mm_32pin_handsolder
uC_{1}←uC_{2}1, uC_{1}→uC_{2}1: TestPoint; TestPoint_Keystone_5010-5014_Multipurpose

Connections:
+3V3: 3V3.1 (1_1), C_{b,uC}1.1, C_{b,uC}2.1, C_{b,uC}3.1, C_{b,uC}4.1, C_{b}16.1, C_{b}17.1, C_{b}18.1, C_{b}19.1, C_{pi}2.1, D1.2 (A), D_{flyback}16.1 (K), D_{flyback}17.1 (K), ESP8266.8 (Vcc), J_{IDReader}1.1, J_{atomizer}1.2, J_{atomizer}2.2, J_{flash}1.4 (C), J_{flash}2.4 (C), LS1.1, LS2.1, R_{I_lim}1.1, R_{I_lim}2.1, R_{I_lim}3.1, R_{PU}1.1, R_{PU}2.1, R_{PU}3.1, R_{PU}4.1, R_{PU}5.1, R_{PU}6.1, R_{PU}7.1, R_{PU}8.1, SW_{bypass}1.1, SW_{bypass}2.1, SW_{bypass}3.1, SW_{bypass}4.1, SW_{bypass}5.1, SW_{bypass}6.1, SW_{bypass}7.1, SW_{bypass}8.1, SW_{bypass}9.1, SW_{bypass}10.1, SW_{bypass}11.1, SW_{bypass}12.1, SW_{bypass}15.1, TFT1.2 (VCC), TFT1.10 (LITE), TFT2.2 (VCC), TFT2.15 (LED+), U1.4 (VREF), U_{3V3DC}1.3 (Vout), U_{Decoder}1.1 (ST), U_{Decoder}1.24 (VDD), uC1.7 (VDD), uC2.7 (VDD)
+12V: 12V1.1 (1_1), C_{b}1.1, C_{b}2.1, C_{b}3.1, C_{b}4.1, C_{b}5.1, C_{b}6.1, C_{b}7.1, C_{b}8.1, C_{b}9.1, C_{b}10.1, C_{b}11.1, C_{b}12.1, C_{b}14.1, C_{b}15.1, C_{filter}1.1, D2.2 (A), D_{flyback}1.1 (K), D_{flyback}2.1 (K), D_{flyback}3.1 (K), D_{flyback}4.1 (K), D_{flyback}5.1 (K), D_{flyback}6.1 (K), D_{flyback}7.1 (K), D_{flyback}8.1 (K), D_{flyback}9.1 (K), D_{flyback}10.1 (K), D_{flyback}11.1 (K), D_{flyback}12.1 (K), D_{flyback}15.1 (K), L_{filter}1.2, M1.1 (+), M2.1 (+), M3.1 (+), M4.1 (+), M5.1 (+), M6.1 (+), M7.1 (+), M8.1 (+), M9.1 (+), M10.1 (+), M11.1 (+), M12.1 (+), M_{latch}1.1 (+), U1.5 (VM)
/Lab7 Electromech/V_{d,motor 1}: D_{flyback}1.2 (A), M1.2 (-), Motor_V_{d}1.1 (1_1), Q1.3 (D)
/Lab7 Electromech/V_{d,motor 2}: D_{flyback}2.2 (A), M2.2 (-), Q2.3 (D)
/Lab7 Electromech/V_{d,motor 3}: D_{flyback}3.2 (A), M3.2 (-), Q3.3 (D)
/Lab7 Electromech/V_{d,motor 4}: D_{flyback}4.2 (A), M4.2 (-), Q4.3 (D)
/Lab7 Electromech/V_{d,motor 5}: D_{flyback}5.2 (A), M5.2 (-), Q5.3 (D)
/Lab7 Electromech/V_{d,motor 6}: D_{flyback}6.2 (A), M6.2 (-), Motor_V_{d}6.1 (1_1), Q6.3 (D)
/Lab7 Electromech/V_{d,motor 7}: D_{flyback}7.2 (A), M7.2 (-), Q7.3 (D)
/Lab7 Electromech/V_{d,motor 8}: D_{flyback}8.2 (A), M8.2 (-), Q8.3 (D)
/Lab7 Electromech/V_{d,motor 9}: D_{flyback}9.2 (A), M9.2 (-), Q9.3 (D)
/Lab7 Electromech/V_{d,motor 10}: D_{flyback}10.2 (A), M10.2 (-), Q10.3 (D)
/Lab7 Electromech/V_{d,motor 11}: D_{flyback}11.2 (A), M11.2 (-), Motor_V_{d}11.1 (1_1), Q11.3 (D)
/Lab7 Electromech/V_{d,motor 12}: D_{flyback}12.2 (A), M12.2 (-), Q12.3 (D)
/Lab7 Electromech/V_{d,solenoid}: D_{flyback}15.2 (A), M_{latch}1.2 (-), Q15.3 (D), Solenoid_V_{d}1.1 (1_1)
/Lab7 IO/D_{Motor}1: JP_{Motor}1.3 (B), U_{Decoder}1.2 (D1)
/Lab7 IO/D_{Motor}2: JP_{Motor}2.3 (B), U_{Decoder}1.3 (D2)
/Lab7 IO/D_{Motor}3: JP_{Motor}3.3 (B), U_{Decoder}1.21 (D3)
/Lab7 IO/D_{Motor}4: JP_{Motor}4.3 (B), U_{Decoder}1.22 (D4)
/Lab7 Microcontroller/uC SPI - uC_{1} ← uC_{2}: uC1.17 (PA10/CLK_OUT), uC2.16 (PA9/RTC_OUT/CLK_OUT), uC_{1}←uC_{2}1.1 (1_1)
/Lab7 Microcontroller/uC SPI - uC_{1} → uC_{2}: uC1.21 (PA14/CLK_OUT/A0_12), uC2.11 (PA4/LFCLK_IN/LFXOUT), uC_{1}→uC_{2}1.1 (1_1)
/Lab7 Microcontroller/uC_{1} - RST: J_{flash}1.5 (C), R_{PU}4.2, SW_{reset}1.2, uC1.6 (NRST)
/Lab7 Microcontroller/uC_{1} - SWCLK: J_{flash}1.2 (B), uC1.27 (PA20/SWCLK)
/Lab7 Microcontroller/uC_{1} - SWDIO: J_{flash}1.1 (A), uC1.26 (PA19/SWDIO)
/Lab7 Microcontroller/uC_{1} - V_{core}: C_{core}1.1, uC1.3 (VCORE)
/Lab7 Microcontroller/uC_{2} - RST: J_{flash}2.5 (C), R_{PU}5.2, SW_{reset}2.2, uC2.6 (NRST)
/Lab7 Microcontroller/uC_{2} - SWCLK: J_{flash}2.2 (B), uC2.27 (PA20/SWCLK)
/Lab7 Microcontroller/uC_{2} - SWDIO: J_{flash}2.1 (A), uC2.26 (PA19/SWDIO)
/Lab7 Microcontroller/uC_{2} - V_{core}: C_{core}2.1, uC2.3 (VCORE)
/Lab7 Power/V_{in,fused}: C_{pi}1.1, F1.1, L_{filter}1.1, U_{3V3DC}1.1 (Vin)
/Lab7 Power/V_{in}: F1.2, J_{USB-C}1.2
Adafruit - CS: TFT1.6 (TFT_CS), uC1.2 (PA27/RTC_OUT/A0_0)
Adafruit - D/C: TFT1.4 (D/C), uC1.20 (PA13)
Adafruit - MOSI: TFT1.7 (MOSI), uC1.25 (PA18/A1_3)
Adafruit - RST: TFT1.3 (RESET), uC1.31 (PA24/A0_3)
Adafruit - SCK: TFT1.8 (SCK), uC1.24 (PA17/A1_2)
GND: C_{b,uC}1.2, C_{b,uC}2.2, C_{b,uC}3.2, C_{b,uC}4.2, C_{b}1.2, C_{b}2.2, C_{b}3.2, C_{b}4.2, C_{b}5.2, C_{b}6.2, C_{b}7.2, C_{b}8.2, C_{b}9.2, C_{b}10.2, C_{b}11.2, C_{b}12.2, C_{b}14.2, C_{b}15.2, C_{b}16.2, C_{b}17.2, C_{b}18.2, C_{b}19.2, C_{core}1.2, C_{core}2.2, C_{pi}1.2, C_{pi}2.2, C_{y}1.2, C_{y}2.2, C_{y}3.2, C_{y}4.2, ESP8266.4 (GND), J_{IDReader}1.4, J_{USB-C}1.1, J_{atomizer}1.3, J_{atomizer}2.3, J_{flash}1.3 (C), J_{flash}2.3 (C), J_{test}1.4, Q1.2 (S), Q2.2 (S), Q3.2 (S), Q4.2 (S), Q5.2 (S), Q6.2 (S), Q7.2 (S), Q8.2 (S), Q9.2 (S), Q10.2 (S), Q11.2 (S), Q12.2 (S), Q15.2 (S), Q16.2 (S), Q17.2 (S), Q18.2 (S), Q19.2 (S), Q20.2 (S), R_{Choke}13.2, R_{Choke}14.2, R_{filter}1.2, R_{vref}1.2, R_{vref}2.2, SW_{reset}1.1, SW_{reset}2.1, TFT1.1 (GND), TFT2.1 (GND), TFT2.16 (LED-), TP_{GND}1.1 (1_1), TP_{GND}2.1 (1_1), TP_{GND}3.1 (1_1), TP_{GND}4.1 (1_1), TP_{GND}5.1 (1_1), TP_{GND}6.1 (1_1), TP_{GND}7.1 (1_1), TP_{GND}8.1 (1_1), TP_{GND}9.1 (1_1), U1.1 (GND), U1.9 (GND), U_{3V3DC}1.2 (GND), U_{Decoder}1.12 (VSS), uC1.8 (VSS), uC2.8 (VSS)
HLG SDC - CS: TFT2.14 (SDC_CS), uC2.32 (PA25/A0_2)
HLG SDC - MISO: TFT2.12 (SDC_MISO), uC2.23 (PA16/A1_1/FCC_IN)
HLG Screen - CS: TFT2.10 (TFT_CS), uC2.2 (PA27/RTC_OUT/A0_0)
HLG Screen - D/C: TFT2.7 (TFTDC), uC2.20 (PA13)
HLG Screen - MOSI: TFT2.8 (TFTMOSI), TFT2.13 (SDC_MOSI), uC2.25 (PA18/A1_3)
HLG Screen- RST: TFT2.6 (RESET), uC2.31 (PA24/A0_3)
HiLetGo - SCK: TFT2.9 (TFTSCK), TFT2.11 (SDCSCK), uC2.24 (PA17/A1_2)
ID Scan - RxD: J_{IDReader}1.3, RxD_{ID}1.1 (1_1), uC1.16 (PA9/RTC_OUT/CLK_OUT)
ID Scan - TxD: J_{IDReader}1.2, TxD_{ID}1.1 (1_1), uC1.15 (PA8)
Keypad - C1: J_{Keypad}1.5, R_{PU}7.2, uC1.4 (PA0)
Keypad - C2: J_{Keypad}1.6, R_{PU}8.2, uC1.5 (PA1)
Keypad - C3: J_{Keypad}1.7, uC1.10 (PA3/LFXIN)
Keypad - C4: J_{Keypad}1.8, uC1.18 (PA11)
Keypad - R1: J_{Keypad}1.1, uC1.11 (PA4/LFCLK_IN/LFXOUT)
Keypad - R2: J_{Keypad}1.2, uC1.14 (PA7/CLK_OUT)
Keypad - R3: J_{Keypad}1.3, uC1.30 (PA23/VREF+)
Keypad - R4: J_{Keypad}1.4, uC1.1 (PA26/A0_1)
Motor PWM: R_{PU}2.2, U_{Decoder}1.23 (INH), uC2.4 (PA0)
Motor_{1}: JP_{Motor}1.1 (A), Motor_In1.1 (1_1), R_{gate}1.2, U_{Decoder}1.9 (S1)
Motor_{2}: JP_{Motor}2.1 (A), R_{gate}2.2, U_{Decoder}1.10 (S2)
Motor_{3}: JP_{Motor}3.1 (A), R_{gate}3.2, U_{Decoder}1.8 (S3)
Motor_{4}: JP_{Motor}4.1 (A), R_{gate}4.2, U_{Decoder}1.7 (S4)
Motor_{5}: R_{gate}5.2, U_{Decoder}1.6 (S5)
Motor_{6}: Motor_In6.1 (1_1), R_{gate}6.2, U_{Decoder}1.5 (S6)
Motor_{7}: R_{gate}7.2, U_{Decoder}1.4 (S7)
Motor_{8}: R_{gate}8.2, U_{Decoder}1.18 (S8)
Motor_{9}: R_{gate}9.2, U_{Decoder}1.17 (S9)
Motor_{10}: R_{gate}10.2, U_{Decoder}1.20 (S10)
Motor_{11}: Motor_In11.1 (1_1), R_{gate}11.2, U_{Decoder}1.19 (S11)
Motor_{12}: R_{gate}12.2, U_{Decoder}1.14 (S12)
unnamed: C_{filter}1.2, R_{filter}1.1
unnamed: D1.1 (K), R_{Choke}13.1
unnamed: D2.1 (K), R_{Choke}14.1
unnamed: D_{flyback}16.2 (A), LS1.2, Q16.3 (D)
unnamed: D_{flyback}17.2 (A), LS2.2, Q17.3 (D)
unnamed: ESP8266.6 (Ch_PD), R_{PU}1.2
unnamed: ESP8266.2 (GPIO0), R_{PU}3.2
unnamed: J_{PA3,LED}1.1, R_{I_lim}1.2
unnamed: J_{PA3,LED}1.2, Q18.3 (D)
unnamed: J_{PA7,LED}1.1, R_{I_lim}2.2
unnamed: J_{PA7,LED}1.2, Q19.3 (D)
unnamed: J_{PA14,LED}1.1, R_{I_lim}3.2
unnamed: J_{PA14,LED}1.2, Q20.3 (D)
unnamed: M_{winch}1.1 (+), U1.6 (OUT1)
unnamed: M_{winch}1.2 (-), U1.8 (OUT2)
unnamed: Q1.1 (G), R_{choke}1.1, R_{gate}1.1
unnamed: Q2.1 (G), R_{choke}2.1, R_{gate}2.1
unnamed: Q3.1 (G), R_{choke}3.1, R_{gate}3.1
unnamed: Q4.1 (G), R_{choke}4.1, R_{gate}4.1
unnamed: Q5.1 (G), R_{choke}5.1, R_{gate}5.1
unnamed: Q6.1 (G), R_{choke}6.1, R_{gate}6.1
unnamed: Q7.1 (G), R_{choke}7.1, R_{gate}7.1
unnamed: Q8.1 (G), R_{choke}8.1, R_{gate}8.1
unnamed: Q9.1 (G), R_{choke}9.1, R_{gate}9.1
unnamed: Q10.1 (G), R_{choke}10.1, R_{gate}10.1
unnamed: Q11.1 (G), R_{choke}11.1, R_{gate}11.1
unnamed: Q12.1 (G), R_{choke}12.1, R_{gate}12.1
unnamed: Q15.1 (G), R_{choke}15.1, R_{gate}15.1
unnamed: R_{choke}1.2, SW_{bypass}1.2
unnamed: R_{choke}2.2, SW_{bypass}2.2
unnamed: R_{choke}3.2, SW_{bypass}3.2
unnamed: R_{choke}4.2, SW_{bypass}4.2
unnamed: R_{choke}5.2, SW_{bypass}5.2
unnamed: R_{choke}6.2, SW_{bypass}6.2
unnamed: R_{choke}7.2, SW_{bypass}7.2
unnamed: R_{choke}8.2, SW_{bypass}8.2
unnamed: R_{choke}9.2, SW_{bypass}9.2
unnamed: R_{choke}10.2, SW_{bypass}10.2
unnamed: R_{choke}11.2, SW_{bypass}11.2
unnamed: R_{choke}12.2, SW_{bypass}12.2
unnamed: R_{choke}15.2, SW_{bypass}15.2
unnamed: R_{vref}1.1, R_{vref}2.1, U1.7 (IPROPI)
PA3/LG1: J_{test}1.1, Q18.1 (G), uC2.10 (PA3/LFXIN)
PA7/LG2: J_{test}1.2, Q19.1 (G), uC2.14 (PA7/CLK_OUT)
PA14/LG3: J_{test}1.3, Q20.1 (G), uC2.21 (PA14/CLK_OUT/A0_12)
Smoke: J_{atomizer}1.1, J_{atomizer}2.1, R_{PU}6.2, uC2.5 (PA1)
Solenoid: R_{gate}15.2, Solenoid_In1.1 (1_1), uC2.19 (PA12/FCC_IN)
Winch_{1}: U1.3 (IN1), uC2.29 (PA22/CLK_OUT/A0_7)
Winch_{2}: U1.2 (IN2), uC2.28 (PA21/A1_7/VREF-)
uC SPI - CS: SPI_{CS}1.1 (1_1), uC1.9 (PA2/ROSC), uC2.9 (PA2/ROSC)
uC SPI - SCK: SPI_{SCK}1.1 (1_1), uC1.19 (PA12/FCC_IN), uC2.18 (PA11)
uC_{1} - ESP Light: ESP8266.3 (GPIO2), uC1.23 (PA16/A1_1/FCC_IN)
uC_{1} - ESP RST: ESP8266.7 (Reset), uC1.32 (PA25/A0_2)
uC_{1} - ESP RxD: ESP8266.1 (RxD), uC1.29 (PA22/CLK_OUT/A0_7)
uC_{1} - ESP TxD: ESP8266.5 (TxD), uC1.28 (PA21/A1_7/VREF-)
uC_{1} - HFXIN: C_{y}1.1, Y1.1, uC1.12 (PA5/HFXIN/FCC_IN)
uC_{1} - HFXOUT: C_{y}2.1, Y1.2, uC1.13 (PA6/HFCLK_IN/HFXOUT)
uC_{1} - Speaker: Q16.1 (G), uC1.22 (PA15/A1_0/DACOUT)
uC_{2} - HFXIN: C_{y}3.1, Y2.1, uC2.12 (PA5/HFXIN/FCC_IN)
uC_{2} - HFXOUT: C_{y}4.1, Y2.2, uC2.13 (PA6/HFCLK_IN/HFXOUT)
uC_{2} - Motor_{1}: JP_{Motor}1.2 (C), uC2.1 (PA26/A0_1)
uC_{2} - Motor_{2}: JP_{Motor}2.2 (C), uC2.30 (PA23/VREF+)
uC_{2} - Motor_{3}: JP_{Motor}3.2 (C), uC2.15 (PA8)
uC_{2} - Motor_{4}: JP_{Motor}4.2 (C), uC2.17 (PA10/CLK_OUT)
uC_{2} - Speaker: Q17.1 (G), uC2.22 (PA15/A1_0/DACOUT)
