tanai-prathapam/-lab7_445L_personal/sw/src/fffff.c

#include "fffff.h"

const NoteData_t fffffLeft[824] = {
{0, 227, 5682},
{13, 227, 5062},
{13, 227, 4778},
{13, 227, 5682},
{13, 227, 4257},
{13, 227, 4778},
{13, 227, 5062},
{13, 227, 4778},
{13, 227, 5682},
{13, 227, 5062},
{13, 227, 4778},
{13, 227, 5682},
{13, 227, 4257},
{13, 227, 4778},
{13, 227, 5062},
{13, 227, 4778},
{13, 227, 5682},
{13, 227, 5062},
{13, 227, 4778},
{13, 227, 5682},
{13, 227, 4257},
{13, 227, 4778},
{13, 227, 5062},
{13, 227, 4778},
{13, 227, 5682},
{13, 227, 5062},
{13, 227, 4778},
{13, 227, 5682},
{13, 227, 4257},
{13, 227, 4778},
{13, 227, 5062},
{13, 227, 4778},
{13, 227, 2841},
{13, 227, 2531},
{13, 227, 2389},
{13, 227, 2841},
{13, 227, 2128},
{13, 227, 2389},
{13, 227, 2531},
{13, 227, 2389},
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
};

const NoteData_t fffffRight[856] = {
{3840, 227, 2841},
{13, 227, 2531},
{13, 227, 2389},
{13, 227, 2841},
{13, 227, 2128},
{13, 227, 2389},
{13, 227, 2531},
{13, 227, 2389},
{13, 227, 2841},
{13, 227, 2531},
{13, 227, 2389},
{13, 227, 2841},
{13, 227, 2128},
{13, 227, 2389},
{13, 227, 2531},
{13, 227, 2389},
{13, 227, 1194},
{13, 227, 1064},
{13, 227, 948},
{13, 227, 1194},
{13, 227, 895},
{13, 227, 948},
{13, 227, 1064},
{13, 227, 948},
{13, 227, 1194},
{13, 227, 1064},
{13, 227, 948},
{13, 227, 1194},
{13, 227, 895},
{13, 227, 948},
{13, 227, 1064},
{13, 227, 948},
{13, 227, 710},
{13, 227, 633},
{13, 227, 597},
{13, 227, 710},
{13, 227, 532},
{13, 227, 597},
{13, 227, 633},
{13, 227, 597},
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
};
