tanai-prathapam/-lab7_445L_personal/sw/src/fffff5voices.c

#include "fffff5voices.h"

const NoteData_t fffffCh0[606] = {
{13440, 227, 355},
{13, 227, 316},
{13, 227, 299},
{13, 227, 355},
{13, 227, 266},
{13, 227, 299},
{13, 227, 316},
{13, 227, 299},
{13, 227, 1420},
{13, 227, 710},
{13, 227, 1420},
{13, 227, 710},
{13, 227, 1265},
{13, 227, 633},
{13, 227, 1265},
{13, 227, 633},
{13, 227, 1194},
{13, 227, 597},
{13, 227, 1194},
{13, 227, 597},
{13, 227, 1064},
{13, 227, 532},
{13, 227, 1064},
{13, 227, 532},
{13, 227, 1004},
{13, 227, 502},
{13, 227, 1004},
{13, 227, 502},
{13, 227, 948},
{13, 227, 474},
{13, 227, 948},
{13, 227, 474},
{13, 227, 1194},
{13, 227, 597},
{13, 227, 1194},
{13, 227, 597},
{13, 227, 1265},
{13, 227, 633},
{13, 227, 1265},
{13, 227, 633},
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
};

const NoteData_t fffffCh1[588] = {
{11520, 227, 710},
{13, 227, 633},
{13, 227, 597},
{13, 227, 710},
{13, 227, 532},
{13, 227, 597},
{13, 227, 633},
{13, 227, 597},
{13, 227, 710},
{13, 227, 633},
{13, 227, 597},
{13, 227, 710},
{13, 227, 532},
{13, 227, 597},
{13, 227, 633},
{13, 227, 597},
{13, 239, 355},
{241, 239, 355},
{241, 239, 316},
{241, 239, 316},
{241, 239, 299},
{241, 239, 299},
{241, 239, 266},
{241, 239, 266},
{241, 239, 251},
{241, 239, 251},
{241, 239, 237},
{241, 239, 237},
{241, 239, 299},
{241, 239, 299},
{241, 239, 316},
{241, 239, 316},
{241, 239, 266},
{241, 239, 266},
{241, 239, 316},
{241, 239, 316},
{241, 239, 355},
{241, 239, 355},
{241, 239, 376},
{241, 239, 376},
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
};

const NoteData_t fffffCh2[672] = {
{7680, 227, 1194},
{13, 227, 1064},
{13, 227, 948},
{13, 227, 1194},
{13, 227, 895},
{13, 227, 948},
{13, 227, 1064},
{13, 227, 948},
{13, 227, 1194},
{13, 227, 1064},
{13, 227, 948},
{13, 227, 1194},
{13, 227, 895},
{13, 227, 948},
{13, 227, 1064},
{13, 227, 948},
{13, 227, 1194},
{13, 227, 1064},
{13, 227, 948},
{13, 227, 1194},
{13, 227, 895},
{13, 227, 948},
{13, 227, 1064},
{13, 227, 948},
{13, 227, 1194},
{13, 227, 1064},
{13, 227, 948},
{13, 227, 1194},
{13, 227, 895},
{13, 227, 948},
{13, 227, 1064},
{13, 227, 948},
{13, 227, 710},
{13, 227, 355},
{13, 227, 355},
{13, 227, 710},
{13, 227, 355},
{13, 227, 355},
{13, 227, 710},
{13, 227, 355},
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
};

const NoteData_t fffffCh3[461] = {
{3840, 227, 2841},
{13, 227, 2531},
{13, 227, 2389},
{13, 227, 2841},
{13, 227, 2128},
{13, 227, 2389},
{13, 227, 2531},
{13, 227, 2389},
{13, 227, 2841},
{13, 227, 2531},
{13, 227, 2389},
{13, 227, 2841},
{13, 227, 2128},
{13, 227, 2389},
{13, 227, 2531},
{13, 227, 2389},
{13, 227, 2841},
{13, 227, 2531},
{13, 227, 2389},
{13, 227, 2841},
{13, 227, 2128},
{13, 227, 2389},
{13, 227, 2531},
{13, 227, 2389},
{13, 227, 2841},
{13, 227, 2531},
{13, 227, 2389},
{13, 227, 2841},
{13, 227, 2128},
{13, 227, 2389},
{13, 227, 2531},
{13, 227, 2389},
{13, 227, 2841},
{13, 227, 2531},
{13, 227, 2389},
{13, 227, 2841},
{13, 227, 2128},
{13, 227, 2389},
{13, 227, 2531},
{13, 227, 2389},
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
};

const NoteData_t fffffCh4[735] = {
{0, 227, 5682},
{13, 227, 5062},
{13, 227, 4778},
{13, 227, 5682},
{13, 227, 4257},
{13, 227, 4778},
{13, 227, 5062},
{13, 227, 4778},
{13, 227, 5682},
{13, 227, 5062},
{13, 227, 4778},
{13, 227, 5682},
{13, 227, 4257},
{13, 227, 4778},
{13, 227, 5062},
{13, 227, 4778},
{13, 227, 5682},
{13, 227, 5062},
{13, 227, 4778},
{13, 227, 5682},
{13, 227, 4257},
{13, 227, 4778},
{13, 227, 5062},
{13, 227, 4778},
{13, 227, 5682},
{13, 227, 5062},
{13, 227, 4778},
{13, 227, 5682},
{13, 227, 4257},
{13, 227, 4778},
{13, 227, 5062},
{13, 227, 4778},
{13, 227, 5682},
{13, 227, 5062},
{13, 227, 4778},
{13, 227, 5682},
{13, 227, 4257},
{13, 227, 4778},
{13, 227, 5062},
{13, 227, 4778},
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
};
