tanai-prathapam/-lab7_445L_personal/sw/src/jacketart.c

const unsigned short jacketart[] = {
 0x5222, 0x41E2, 0x41E2, 0x41E2, 0x41E2, 0x41E2, 0x41E2, 0x41E2, 0x41E2, 0x41E2, 0x41E2, 0x41E2, 0x41E2, 0x41E2, 0x49E2, 0x4A02,
 0x49E2, 0x41E2, 0x41E2, 0x41E2, 0x41E2, 0x41E2, 0x41E2, 0x41E2, 0x41E2, 0x41E2, 0x41E2, 0x41E2, 0x41E2, 0x41E2, 0x41E2, 0x41E2,
 0x41E2, 0x41E2, 0x41E2, 0x41E2, 0x41E2, 0x41E2, 0x41E2, 0x41E2, 0x41E2, 0x41E2, 0x41E2, 0x41E2, 0x41E2, 0x41E2, 0x41E2, 0x41E2,
 0x41E2, 0x41E2, 0x41E2, 0x41E2, 0x41E2, 0x41E2, 0x41E2, 0x41E2, 0x41E2, 0x41E2, 0x41E2, 0x41E2, 0x41E2, 0x41E2, 0x41E2, 0x41E2,
 0x41E2, 0x41E2, 0x41E2, 0x41E2, 0x41E2, 0x41E2, 0x41E2, 0x41E2, 0x41E2, 0x41E2, 0x41E2, 0x41E2, 0x41E2, 0x41E2, 0x41E2, 0x41E2,
 0x41E2, 0x41E2, 0x41E2, 0x41E2, 0x41E2, 0x41E2, 0x41E2, 0x41E2, 0x41E2, 0x41E2, 0x41E2, 0x41E2, 0x41E2, 0x41E2, 0x41E2, 0x41E2,
 0x41E2, 0x41E2, 0x41E2, 0x41E2, 0x41E2, 0x41E2, 0x41E2, 0x41E2, 0x4A23, 0x5AA4, 0x6AE4, 0x5243, 0x41E2, 0x41E2, 0x41E2, 0x41E2,
 0x41E2, 0x41E2, 0x41E2, 0x41E2, 0x41E2, 0x41E2, 0x41E2, 0x41E2, 0x41E2, 0x41E2, 0x41E2, 0x41E2, 0x41E2, 0x41E2, 0x49E2, 0x4A22,
 0x5222, 0x3982, 0x3982, 0x3982, 0x3982, 0x3982, 0x3982, 0x3982, 0x3982, 0x3982, 0x3982, 0x3982, 0x3982, 0x3982, 0x4A23, 0x5AC4,
 0x5264, 0x4A23, 0x39A2, 0x3982, 0x3982, 0x3982, 0x3982, 0x3982, 0x3982, 0x3982, 0x3982, 0x3982, 0x3982, 0x3982, 0x3982, 0x3982,
 0x3982, 0x3982, 0x3982, 0x3982, 0x3982, 0x3982, 0x3982, 0x3982, 0x3982, 0x3982, 0x3982, 0x3982, 0x3982, 0x3982, 0x3982, 0x3982,
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
 0x5243, 0x5263, 0x5243, 0x5243, 0x5243, 0x5243, 0x5243, 0x62C4, 0x5A83, 0x7365, 0x6B25, 0x5243, 0x5243, 0x5243, 0x5243, 0x5243,
 0x5243, 0x5243, 0x5243, 0x5243, 0x5243, 0x5243, 0x5243, 0x5243, 0x5263, 0x5243, 0x5263, 0x5243, 0x5243, 0x5243, 0x4A02, 0x5243,
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

};
