tanai-prathapam/-lab7_445L_personal/sw/src/Dump.c

// Dump.c
// Your solution to ECE319K Lab 3 Fall 2026
// Author: Your name
// Last Modified: Your date


#include <ti/devices/msp/msp.h>
#include "../inc/Timer.h"
#include "../inc/Clock.h"
#include "Dump.h"
#include "../inc/LaunchPad.h"
#define MAXBUF 50
uint32_t DataBuffer[MAXBUF];
uint32_t TimeBuffer[MAXBUF];
volatile uint32_t DebugCnt; // 0 to MAXBUF (0 is empty, MAXBUF is full)

// *****Debug_Init******
// Initializes your index or pointer.
// Input: none
// Output:none
void Debug_Init(void){
// students write this for ECE319K Lab 3
// This function should also initialize Timer G12, call TimerG12_Init.
  // GPIO outputs for logic-analyzer ISR profiling.
  IOMUX->SECCFG.PINCM[PB0INDEX]  = 0x00000081;
  IOMUX->SECCFG.PINCM[PB3INDEX]  = 0x00000081;
  IOMUX->SECCFG.PINCM[PB16INDEX] = 0x00000081;
  IOMUX->SECCFG.PINCM[PB19INDEX] = 0x00000081;
  IOMUX->SECCFG.PINCM[PB20INDEX] = 0x00000081;
  IOMUX->SECCFG.PINCM[PB13INDEX] = 0x00000081;

  uint32_t debugMask = (SYS_MASK)  | (A0_MASK)  | (A1_MASK) | (G6_MASK) | (G7_MASK) | (G12_MASK);

  GPIOB->DOUTCLR31_0 = debugMask; // Initially low.
  GPIOB->DOE31_0 |= debugMask;    // Enable outputs.
  DebugCnt = 0; // 0 is empty
  TimerG8_Init(1, 1);
}

// *****Debug_Dump******
// Records one data and one time into the two arrays.
// Input: data is value to store in DataBuffer
// Output: 1 for success, 0 for failure (buffers full)
uint32_t Debug_Dump(uint32_t data){
// students write this for ECE319K Lab 3
// The software simply reads TIMG12->COUNTERREGS.CTR to get the current time in bus cycles.
  if(DebugCnt >= MAXBUF) return 0; // failure
  DataBuffer[DebugCnt] = data;
  TimeBuffer[DebugCnt] = TIMG8->COUNTERREGS.CTR;
  DebugCnt++;
  return 1; // success
}
// *****Debug_Dump2******
// Always record data and time on the first call to Debug_Dump2
// However, after the first call
//    Records one data and one time into the two arrays, only if the data is different from the previous call.
//    Do not record data or time if the data is the same as the data from the previous call
// Input: data is value to store in DataBuffer
// Output: 1 for success (saved or skipped), 0 for failure (buffers full)
uint32_t Debug_Dump2(uint32_t data){
// students write this for Lab 3
// The software simply reads TIMG12->COUNTERREGS.CTR to get the current time in bus cycles.
  if(DebugCnt >= MAXBUF) return 0; // failure
  if(DebugCnt == 0){
      DataBuffer[DebugCnt] = data;
      TimeBuffer[DebugCnt] = TIMG12->COUNTERREGS.CTR;
      DebugCnt++;
      return 1;
  }
  if(data != DataBuffer[DebugCnt-1]){
    DataBuffer[DebugCnt] = data;
    TimeBuffer[DebugCnt] = TIMG12->COUNTERREGS.CTR;
    DebugCnt++;
  }
  return 1; // success
}
// *****Debug_Period******
// Calculate period of the recorded data using mask
// Input: mask specifies which bit(s) to observe
// Output: period in bus cycles
// Period is defined as rising edge (low to high) to the next rising edge.
// Return 0 if there is not enough collected data to calculate period .
uint32_t Debug_Period(uint32_t mask){
// students write this for Lab 3
// This function should not alter the recorded data.
// AND each recorded data with mask,
//    if nonzero the signal is considered high.
//    if zero, the signal is considered low.
  uint32_t num=0; // number of period measurements (need at least 1)
  uint32_t i=0;   // search index
  uint32_t lastTime=0;
  uint32_t p;
  uint32_t sum = 0;
  uint32_t first = 0; // have not found any rising edges yet
  uint32_t flag=0;  // search for 0
  while(i<DebugCnt){
    if(flag == 0){  // searching for 0
      if((DataBuffer[i]&mask) == 0){
        flag = 1; // look for 1
      }
    }else{ // searching for 1
      if((DataBuffer[i]&mask) != 0){
        if(first){ // not first edge
          p = lastTime - TimeBuffer[i];
          sum = sum+p;
          num++;
        }
        first = 1; // found at least one rising edge
        lastTime =  TimeBuffer[i];
        flag = 0; // look for 0
      }
    }
    i++;
  }
  if(num == 0){
    return 0;
  }
  return sum/num; // average period
}


// *****Debug_Duty******
// Calculate duty cycle of the recorded data using mask
// Input: mask specifies which bit(s) to observe
// Output: period in percent (0 to 100)
// Period is defined as rising edge (low to high) to the next rising edge.
// High is defined as rising edge (low to high) to the next falling edge.
// Duty cycle is (100*High)/Period
// Return 0 if there is not enough collected data to calculate duty cycle.
uint32_t Debug_Duty(uint32_t mask){
// students write this for Lab 3
// This function should not alter the recorded data.
// AND each recorded data with mask,
//    if nonzero the signal is considered high.
//    if zero, the signal is considered low.
  uint32_t num=0; // number of period measurements (need at least 1)
  uint32_t num2=0; // number of period measurements (need at least 1)
  uint32_t i=0;   // search index
  uint32_t lastTime=0;
  uint32_t p,pw;
  uint32_t sum = 0;
  uint32_t sum2 = 0;
  uint32_t first = 0; // have not found any rising edges yet
  uint32_t flag=0;  // search for 0
  while(i<DebugCnt){
    if(flag == 0){  // searching for 0
      if((DataBuffer[i]&mask) == 0){
        if(first){ // not first edge
          pw = lastTime - TimeBuffer[i];
          sum2 = sum2+pw;
          num2++;
        }
        flag = 1; // look for 1
      }
    }else{ // searching for 1
      if((DataBuffer[i]&mask) != 0){
        if(first){ // not first edge
          p = lastTime - TimeBuffer[i];
          sum = sum+p;
          num++;
        }
        first = 1; // found at least one rising edge
        lastTime =  TimeBuffer[i];
        flag = 0; // look for 0
      }
    }
    i++;
  }
  if((num == 0)||(num2 == 0)){
    return 0;
  }
  p = sum/num; // average period
  pw = sum2/num2;
  return (100*pw)/p; // average duty cycle in percent
}

// Lab2 specific debugging code
uint32_t Theperiod;
void Dump(void){
  uint32_t out = GPIOB->DOUT31_0&0x0070000; // PB18-PB16 outputs
  uint32_t in = GPIOB->DIN31_0&0x0F;        // PB3-PB0 inputs
  uint32_t data = out|in;                   // PB18-PB16, PB3-PB0
  uint32_t result = Debug_Dump(data);       // calls your Lab3 function
  if(result == 0){ // 0 means full
    Theperiod = Debug_Period(1<<18);        // calls your Lab3 function
//   __asm volatile("bkpt; \n"); // breakpoint here
// observe Theperiod
  }
}

// time jitter variables
uint32_t MinT = UINT32_MAX;;    // minimum(TimeBuf[i-1] – TimeBuf[i]) for i equals 1 to BUFSIZE-1
uint32_t MaxT = 0;    // maximum(TimeBuf[i-1] – TimeBuf[i]) for i equals 1 to BUFSIZE-1
uint32_t minIndex, maxIndex; 
uint32_t Jitter;  // MaxT – MinT (in bus cycles)
#define MAXPERIOD 64
uint16_t Periods[MAXPERIOD];  // histogram of times between ADC triggers, optional

void CalculateJitter(void){int i = 1;
// MaxT = maximum(Time[i-1] – Time[i]) for i equals 1 to 999
// MinT = minimum(Time[i-1] – Time[i]) for i equals 1 to 999
// Jitter = MaxT – MinT 
   // ****ECE445L write this ****
  for(; i < DebugCnt; i++){
    
    uint32_t currentT = (TimeBuffer[i - 1] - TimeBuffer[i]) & 0xFFFF;

    if(currentT < MinT){
      MinT = currentT;
      minIndex = i;
    }
    if(MaxT < currentT){
      MaxT = currentT;
      maxIndex = i;
    }
  }
  Jitter = MaxT - MinT;
}
