tanai-prathapam/-lab7_445L_personal/sw/src/Mister.h

// File **********Mister.h***********
// Lab 7
// Programs to interface with Mister

#ifndef MISTER_H
#define MISTER_H

//---------------------Mister_Init---------------------
// initialize mister interface
// Input: none
// Output: none 
void Mister_Init(void);

//---------------------Mister_On---------------------
// turn on mister
// Input: none
// Output: none 
void Mister_On(void);

//---------------------Mister_Off---------------------
// turn off mister
// Input: none
// Output: none 
void Mister_Off(void);

#endif
