tanai-prathapam/-lab7_445L_personal/sw/src/mailbox.c

// File **********mailbox.c***********
// Programs to implement a communication mailbox   
// ECE445L Fall 2026
//    Jonathan W. Valvano 6/28/26

#include <stdint.h>

  // ****ECE445L write this ****
  
