tanai-prathapam/-lab7_445L_personal/sw/src/piano256-data.c

#include "piano256-data.h"

const uint8_t piano_wave[256] = {
157,
160,
156,
153,
148,
141,
135,
129,
123,
120,
116,
114,
112,
111,
112,
113,
115,
117,
119,
122,
124,
126,
127,
127,
127,
125,
123,
119,
116,
111,
107,
101,
95,
88,
80,
71,
62,
54,
47,
40,
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
}; 

#if TEST_ENVELOPE == 0
const uint8_t piano_envelope[128] = {
255,
255,
255,
255,
255,
255,
255,
255,
255,
255,
255,
255,
255,
255,
255,
255,
255,
255,
255,
255,
255,
255,
255,
255,
255,
255,
250,
245,
240,
235,
231,
226,
221,
217,
212,
207,
203,
199,
194,
190,
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
};
#else 
const uint8_t piano_envelope[128] = {
255,
255,
255,
255,
255,
255,
255,
255,
255,
255,
255,
255,
255,
255,
255,
255,
255,
255,
255,
255,
255,
255,
255,
255,
255,
255,
255,
255,
255,
255,
255,
255,
255,
255,
255,
255,
255,
255,
255,
255,
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
};
#endif
