tanai-prathapam/-lab7_445L_personal/(commit log)

2026-10-25 finished preliminary pin assignment
2026-10-29 started pcb layout
2026-10-30 Worked on PCB layou/route while Egan was busy
2026-10-30 Updated lab report and started the bom a little
2026-10-31 current chart added into report
2026-10-31 current chart updates
2026-11-03 submitted PCB design
2026-11-07 Added misters, usb-pd to BOM; fixed LCD Group on pin assignment
2026-11-07 CAD folder created with coil .3mf file; add updated 7breport, updated bom, updated req doc
